insinfo/8SoundsUSB/SoundCard_REV2.jpg

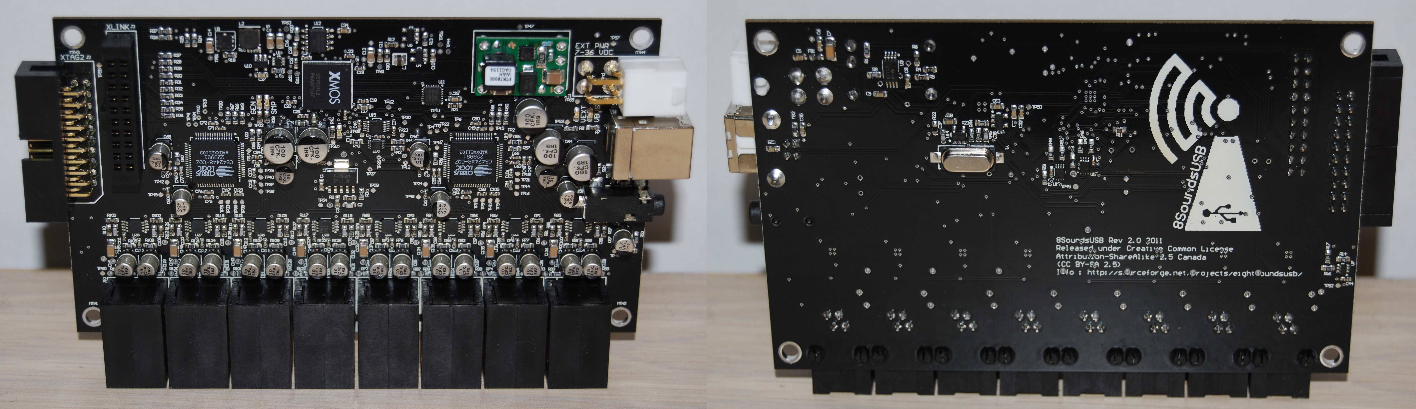
SoundCard_REV2.jpg
