insinfo/8SoundsUSB/8SoundsUSB.jpeg

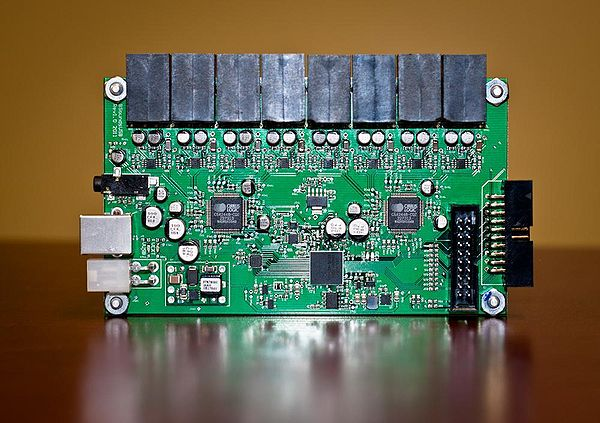
8SoundsUSB.jpeg
