insinfo/8SoundsUSB/README.md

# 8SoundsUSB
8 chanel USB SoundCard Hardware Design
