insinfo/8SoundsUSB/FabAssyPackages/8SoundsUSB-MIC_REV2.0.1_1/README.txt

Microphone PCB assembly procedure (8SoundsUSb-MIC)
This procedure occurs because of the configuration of the PCB. The electret microphone must assemble before the RJ-11 Connector 
1.	First mount the electret microphone and cut the lead flush with board, then solder it
2.	Second assemble the RJ-11 connector
