insinfo/8SoundsUSB/FabAssyPackages/8SoundsUSB_REV2.0.1_1/README.txt

Note that the board outline is in the Keepout layer .GKO.
