insinfo/8SoundsUSB/Hardware Design Files/8SoundsUSB-MIC_REV2.0.1/8SoundsUSB-MIC/Project Outputs for Microphone/Board Information - 8SoundsUSB-MIC.html

Altium customize

# Board Information Report

Date | : | 2011-12-08
Time | : | 20:31:57
Elapsed Time | : | 00:00:00
Filename | : | C:\SVN-S7\Altium\PCBs\8SoundsUSB-MIC\8SoundsUSB-MIC.PcbDoc
Units | : | mmmils

## Contents

Contents

Board Specification

General

Routing

Routing Information

Layer Information

Layer Information

Layer Pairs

Board Holes

Non-Plated Hole Size

Plated Hole Size

Board Slots

Non-Plated Slot Size

Plated Slot Size

Board Square Holes

Non-Plated Square Hole Size

Plated Square Hole Size

Other

Top Layer Annular Ring Size

Mid Layer Annular Ring Size

Bottom Layer Annular Ring Size

Pad Solder Mask

Pad Paste Mask

Pad Pwr/Gnd Expansion

Pad Relief Conductor Width

Pad Relief Air Gap

Pad Relief Entries

Via Solder Mask

Via Pwr/Gnd Expansion

Track Width

Arc Line Width

Arc Radius

Arc Degrees

Text Height

Text Width

Net Track Width

Net Via Size

## Board Specification

General
Board Size | 25.4mm x 23.4mm
Components on board | 22

Back to top

## Routing

Routing Information
Routing completion | 100,00%
Connections | 34
Connections routed | 34
Connections remaing | 0

Back to top

## Layer Information

Layer | Arcs | Pads | Vias | Tracks | Texts | Fills | Regions | ComponentBodies
Top Layer | 0 | 45 | 0 | 127 | 0 | 0 | 2 | 0
Bottom Layer | 0 | 12 | 0 | 71 | 0 | 0 | 2 | 0
Mechanical 1 | 0 | 0 | 0 | 0 | 0 | 0 | 0 | 23
Mechanical 13 | 0 | 0 | 0 | 8 | 0 | 0 | 0 | 0
Mechanical 15 | 0 | 0 | 0 | 4 | 0 | 0 | 0 | 0
Top Overlay | 2 | 0 | 0 | 1453 | 37 | 0 | 0 | 0
Bottom Overlay | 0 | 0 | 0 | 4 | 12 | 0 | 0 | 0
Top Paste | 0 | 0 | 0 | 0 | 0 | 0 | 0 | 0
Bottom Paste | 0 | 0 | 0 | 0 | 0 | 0 | 0 | 0
Top Solder | 0 | 0 | 0 | 0 | 0 | 0 | 0 | 0
Bottom Solder | 0 | 0 | 0 | 0 | 0 | 0 | 0 | 0
Drill Guide | 0 | 0 | 0 | 0 | 0 | 0 | 0 | 0
Keep-Out Layer | 0 | 0 | 0 | 5 | 0 | 0 | 0 | 0
Drill Drawing | 0 | 0 | 0 | 0 | 0 | 0 | 0 | 0
Multi-Layer | 0 | 11 | 18 | 0 | 0 | 0 | 0 | 0
Total | 2 | 68 | 18 | 1672 | 49 | 0 | 4 | 23

Back to top

Layer Pairs | Vias
Top Layer - Bottom Layer | 18
Total | 18

Back to top

## Board Holes

Non-Plated Hole Size | Pads | Vias
Total | 0 | 0

Back to top

Plated Hole Size | Pads | Vias
0mm | 57 | 0
0.3048mm | 0 | 18
0.7112mm | 3 | 0
1.15mm | 2 | 0
3.25mm | 2 | 0
3.5mm | 4 | 0
Total | 68 | 18

Back to top

## Board Slots

Non-Plated Slot Size / Length | Pads
Total | 0

Back to top

Plated Slot Size / Length | Pads
Total | 0

Back to top

## Board Square Holes

Non-Plated Square Hole Size | Pads
Total | 0

Back to top

Plated Square Hole Size | Pads
Total | 0

Back to top

## Other

Top Layer Annular Ring Size | Count
-3.25mm | 2
0.2888mm | 3
0.3048mm | 18
0.35mm | 2
1.5mm | 4
Total | 29

Back to top

Mid Layer Annular Ring Size | Count
-3.25mm | 2
0.2888mm | 3
0.3048mm | 18
0.35mm | 2
1.5mm | 4
Total | 29

Back to top

Bottom Layer Annular Ring Size | Count
-3.25mm | 2
0.2888mm | 3
0.3048mm | 18
0.35mm | 2
1.5mm | 4
Total | 29

Back to top

Pad Solder Mask | Count
0.1016mm | 68
Total | 68

Back to top

Pad Paste Mask | Count
0mm | 68
Total | 68

Back to top

Pad Pwr/Gnd Expansion | Count
0.508mm | 68
Total | 68

Back to top

Pad Relief Conductor Width | Count
0.254mm | 68
Total | 68

Back to top

Pad Relief Air Gap | Count
0.254mm | 68
Total | 68

Back to top

Pad Relief Entries | Count
4 | 68
Total | 68

Back to top

Via Solder Mask | Count
0.1016mm | 18
Total | 18

Back to top

Via Pwr/Gnd Expansion | Count
0.508mm | 18
Total | 18

Back to top

Track Width | Count
0.001mm | 1
0.0134mm | 1437
0.1mm | 16
0.254mm | 218
Total | 1672

Back to top

Arc Line Width | Count
0.25mm | 1
0.254mm | 1
Total | 2

Back to top

Arc Radius | Count
0.125mm | 1
4.85mm | 1
Total | 2

Back to top

Arc Degrees | Count
360 | 2
Total | 2

Back to top

Text Height | Count
0.3mm | 3
0.5mm | 22
1.524mm | 24
Total | 49

Back to top

Text Width | Count
0.05mm | 21
0.08mm | 4
0.1524mm | 2
0.254mm | 22
Total | 49

Back to top

Net Track Width | Count
1065.7302mm | 16
Total | 16

Back to top

Net Via Size | Count
0.6096mm | 16
Total | 16

Back to top
