insinfo/8SoundsUSB/Hardware Design Files/8SoundsUSB_REV2.0.1/8SoundsUSB/PCB/8SoundsUSB.PcbDoc.htm

Altium Reporting Options

# File in Previous Format

Date | : | 29/10/2012
Time | : | 23:22:21
Filename | : | C:\Users\Isaque\Desktop\Estudo Placa de som Hardware\Projeto 8 Sounds USB\Hardware Design Files\8SoundsUSB_REV2.0.1\8SoundsUSB\PCB\8SoundsUSB.PcbDoc

Version | Warning

This file was generated by an earlier version of the software
