insinfo/8SoundsUSB/Hardware Design Files/8SoundsUSB_REV2.0.1/8SoundsUSB/PCB/Project Outputs for 8SoundsUSB/Board Information - 8SoundsUSB.html

Altium customize

# Board Information Report

Date | : | 2011-12-07
Time | : | 19:11:10
Elapsed Time | : | 00:00:00
Filename | : | C:\SVN-S7\Altium\PCBs\8SoundsUSB\PCB\8SoundsUSB.PcbDoc
Units | : | mmmils

## Contents

Contents

Board Specification

General

Routing

Routing Information

Layer Information

Layer Information

Layer Pairs

Board Holes

Non-Plated Hole Size

Plated Hole Size

Board Slots

Non-Plated Slot Size

Plated Slot Size

Board Square Holes

Non-Plated Square Hole Size

Plated Square Hole Size

Other

Top Layer Annular Ring Size

Mid Layer Annular Ring Size

Bottom Layer Annular Ring Size

Pad Solder Mask

Pad Paste Mask

Pad Pwr/Gnd Expansion

Pad Relief Conductor Width

Pad Relief Air Gap

Pad Relief Entries

Via Solder Mask

Via Pwr/Gnd Expansion

Track Width

Arc Line Width

Arc Radius

Arc Degrees

Text Height

Text Width

Net Track Width

Net Via Size

## Board Specification

General
Board Size | 126.1mm x 74.1mm
Components on board | 415

Back to top

## Routing

Routing Information
Routing completion | 100,00%
Connections | 885
Connections routed | 885
Connections remaing | 0

Back to top

## Layer Information

Layer | Arcs | Pads | Vias | Tracks | Texts | Fills | Regions | ComponentBodies
Top Layer | 0 | 996 | 0 | 2706 | 0 | 0 | 20 | 0
GND PLANE | 0 | 0 | 0 | 4 | 0 | 0 | 1 | 0
POWER PLANE | 0 | 0 | 0 | 22 | 0 | 0 | 3 | 0
Bottom Layer | 0 | 119 | 0 | 977 | 0 | 0 | 15 | 0
Mechanical 1 | 0 | 0 | 0 | 32 | 0 | 0 | 0 | 22
Mechanical 13 | 6 | 0 | 0 | 56 | 0 | 0 | 0 | 14
Mechanical 15 | 0 | 0 | 0 | 80 | 0 | 0 | 0 | 0
Top Overlay | 30 | 0 | 0 | 467 | 742 | 0 | 0 | 0
Bottom Overlay | 7 | 0 | 0 | 30 | 100 | 0 | 3 | 0
Top Paste | 0 | 0 | 0 | 0 | 0 | 0 | 0 | 0
Bottom Paste | 0 | 0 | 0 | 0 | 0 | 0 | 0 | 0
Top Solder | 0 | 0 | 0 | 0 | 0 | 0 | 0 | 0
Bottom Solder | 0 | 0 | 0 | 0 | 0 | 0 | 0 | 0
Drill Guide | 0 | 0 | 0 | 0 | 0 | 0 | 0 | 0
Keep-Out Layer | 0 | 0 | 0 | 12 | 0 | 0 | 0 | 0
Drill Drawing | 0 | 0 | 0 | 0 | 0 | 0 | 0 | 0
Multi-Layer | 0 | 119 | 311 | 0 | 0 | 0 | 0 | 0
Total | 43 | 1234 | 311 | 4386 | 842 | 0 | 42 | 36

Back to top

Layer Pairs | Vias
Top Layer - Bottom Layer | 311
Total | 311

Back to top

## Board Holes

Non-Plated Hole Size | Pads | Vias
Total | 0 | 0

Back to top

Plated Hole Size | Pads | Vias
0mm | 951 | 0
0.3048mm | 9 | 260
0.33mm | 0 | 4
0.508mm | 0 | 20
0.7112mm | 0 | 27
0.89mm | 32 | 0
0.92mm | 4 | 0
0.9398mm | 40 | 0
1.4mm | 5 | 0
1.7mm | 2 | 0
1.8mm | 4 | 0
2.3mm | 2 | 0
3mm | 1 | 0
3.25mm | 16 | 0
3.5mm | 4 | 0
Total | 1070 | 311

Back to top

## Board Slots

Non-Plated Slot Size / Length | Pads
Total | 0

Back to top

Plated Slot Size / Length | Pads
Total | 0

Back to top

## Board Square Holes

Non-Plated Square Hole Size | Pads
Total | 0

Back to top

Plated Square Hole Size | Pads
Total | 0

Back to top

## Other

Top Layer Annular Ring Size | Count
-3.25mm | 16
-3mm | 1
-1.7mm | 2
0.1016mm | 32
0.2032mm | 9
0.3048mm | 228
0.33mm | 4
0.3302mm | 40
0.508mm | 20
0.5588mm | 27
0.68mm | 4
0.9mm | 32
1mm | 5
1.5mm | 6
1.5mm | 4
Total | 430

Back to top

Mid Layer Annular Ring Size | Count
-3.25mm | 16
-3mm | 1
-1.7mm | 2
0.0762mm | 40
0.1016mm | 32
0.2032mm | 9
0.3048mm | 228
0.33mm | 4
0.508mm | 20
0.5588mm | 27
0.68mm | 4
0.9mm | 32
1mm | 5
1.5mm | 6
1.5mm | 4
Total | 430

Back to top

Bottom Layer Annular Ring Size | Count
-3.25mm | 16
-3mm | 1
-1.7mm | 2
0.1016mm | 32
0.2032mm | 9
0.3048mm | 228
0.33mm | 4
0.3302mm | 40
0.508mm | 20
0.5588mm | 27
0.68mm | 4
0.9mm | 32
1mm | 5
1.5mm | 6
1.5mm | 4
Total | 430

Back to top

Pad Solder Mask | Count
0mm | 9
0.1016mm | 1225
Total | 1234

Back to top

Pad Paste Mask | Count
0mm | 1234
Total | 1234

Back to top

Pad Pwr/Gnd Expansion | Count
0.508mm | 1234
Total | 1234

Back to top

Pad Relief Conductor Width | Count
0.254mm | 1234
Total | 1234

Back to top

Pad Relief Air Gap | Count
0.254mm | 1234
Total | 1234

Back to top

Pad Relief Entries | Count
4 | 1234
Total | 1234

Back to top

Via Solder Mask | Count
0.1016mm | 311
Total | 311

Back to top

Via Pwr/Gnd Expansion | Count
0.508mm | 311
Total | 311

Back to top

Track Width | Count
0.05mm | 5
0.1mm | 388
0.1524mm | 1344
0.2mm | 102
0.2032mm | 565
0.254mm | 408
0.3048mm | 513
0.508mm | 804
0.635mm | 225
0.762mm | 1
0.889mm | 2
1.016mm | 8
1.27mm | 21
Total | 4386

Back to top

Arc Line Width | Count
0.1mm | 6
0.25mm | 24
0.254mm | 4
0.4mm | 8
0.6mm | 1
Total | 43

Back to top

Arc Radius | Count
0.0254mm | 1
0.05mm | 3
0.125mm | 24
0.2mm | 8
0.3mm | 1
0.5mm | 6
Total | 43

Back to top

Arc Degrees | Count
354 | 1
360 | 42
Total | 43

Back to top

Text Height | Count
0.5mm | 416
1mm | 16
1.524mm | 409
1.8mm | 1
Total | 842

Back to top

Text Width | Count
0.08mm | 416
0.15mm | 1
0.16mm | 15
0.254mm | 409
0.3mm | 1
Total | 842

Back to top

Net Track Width | Count
1423.4834mm | 227
Total | 227

Back to top

Net Via Size | Count
0.6096mm | 227
Total | 227

Back to top
