insinfo/8SoundsUSB/Hardware Design Files/README.txt

REVISIONS
Changes made from Rev2.0 to REV2.0.1 
•	Part number and mafucfacturer added in 8SounsdUSB.xls file. (all other files are still good at REV2.0)
