insinfo/8SoundsUSB/BlockDiagram.png

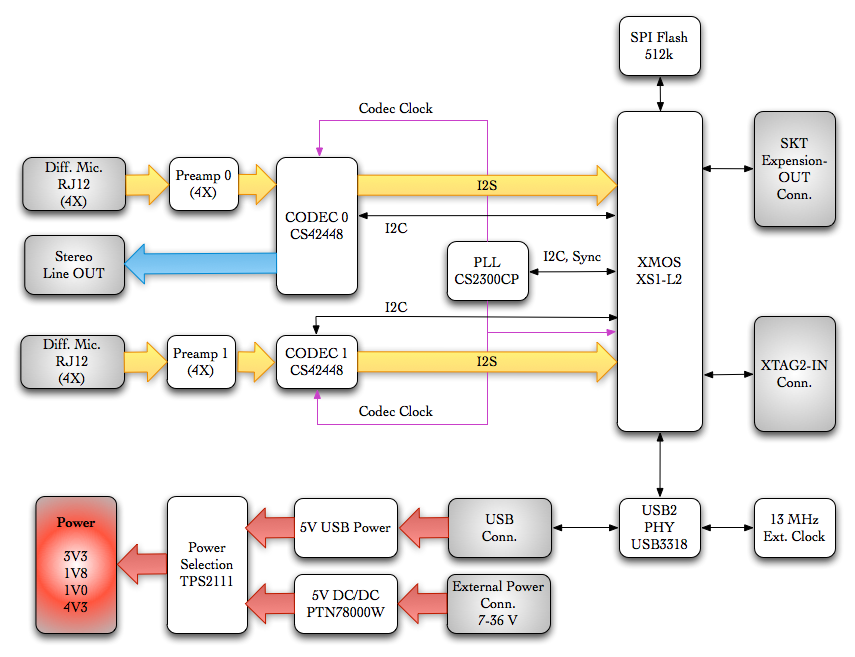
BlockDiagram.png
