insinfo/8SoundsUSB/FabAssyPackages/8SoundsUSB-Cable_BOM.xls

Designator | Manufacturer | Part Number | Quantity
RJ-11PCB | Stewart Connector | 940-SP-3046 | 1
RJ-11MIC | Stewart Connector | 940-SP-3046 | 1
Cable twisted pair, 4-conductors, 22, 24 ,26 AWG |  |  | 1m
