insinfo/8SoundsUSB/FabAssyPackages/8SoundsUSB_REV2.0.1_1/8SoundsUSB_BOM.xls

Designator | Description | Manufacturer | Part Number | Footprint | Quantity
C1, C3, C13 | MLCC 1uF 0603 X5R 10V | Murata | GRM188R61A105KA61 | 3-0603 | 3
C2 | MLCC 15pF 0603 C0G 50V | Murata | GRM1885C1H150JA01D | 3-0603 | 1
C4, C64, C65, C82, C83 | Al Elec 100uF CaseD 16V | Panasonic | EEEFK1C101P | AL_ELEC_SMD_D | 5
C5, C6 | MLCC 0.10uF 0603 X7R 50V | Murata | GRM188R71H104KA93D | 3-0603 | 2
C7, C133, C134, C135, C136, C141, C142, C143, C144 | MLCC 2.2uF 1206 X7R 50V | Murata | GRM31CR71H225KA88L | 8-1206 | 9
C8, C9, C28, C30, C32, C33, C34, C35, C39 | MLCC 100nF 0603 X7R 16V | Murata | GRM188R71C104KA01 | 3-0603 | 9
C10, C17, C26 | MLCC 4.7uF 0603 X5R 6.3V | Murata | GRM188R60J475KE19 | 3-0603 | 3
C11 | MLCC 330pF 0603 COG 50V | Murata | GRM1885C1H331JA01 | 3-0603 | 1
C12, C14, C15, C16 | MLCC 10uF 0805 X5R 10V | Murata | GRM21BR61A106KE19 | 6-0805 | 4
C18, C19, C20, C21, C22, C23, C24, C25, C36, C40, C41, C42, C43, C44, C47, C52, C53, C56, C62, C63, C66, C69, C71, C74, C75, C78, C80, C81, C84, C137, C138, C139, C140, C145, C146, C147, C148 | MLCC 100nF 0402 X7R 16V | Murata | GRM155R71C104KA88 | 2-0402 | 37
C27, C29 | MLCC 10nF 0603 X7R 50V | Murata | GRM188R71H103KA01 | 3-0603 | 2
C31 | MLCC 2.2uF 0603 X5R 10V | Murata | GRM188R61A225KE34 | 3-0603 | 1
C37, C38 | MLCC 33pF 0603 COG 50V | Murata | GRM1885C1H330JA01 | 3-0603 | 2
C45, C46, C67, C68, C89, C90, C95, C96, C101, C102, C107, C108, C113, C114, C119, C120, C125, C126, C131, C132 | Al Elec 10uF CaseB 16V | Panasonic | EEEFK1C100R | AL_ELEC_SMD_B | 20
C48, C49, C50, C51, C54, C55, C70, C72, C73, C76, C77, C91, C92, C103, C104, C115, C116, C127, C128 | MLCC 10000pF 0402 X7R 25V | Murata | GRM155R71E103KA01D | 2-0402 | 19
C57, C59, C61, C79 | Al Elec 4.7uF CaseB 35V | Panasonic | EEEFK1V4R7R | AL_ELEC_SMD_B | 4
C58, C60 | MLCC 2.2uF 0603 X5R 10V | Murata | GRM1885C1H222JA01 | 3-0603 | 2
C85, C86, C87, C88, C97, C98, C99, C100, C109, C110, C111, C112, C121, C122, C123, C124 | MLCC 470pF 0603 COG 50V | Murata | GRM1885C1H471JA01D | 3-0603 | 16
C93, C94, C105, C106, C117, C118, C129, C130 | Temperature Compensating 2700pF 0402 COG 10V | Murata | GRM1557U1A272JA01D | 2-0402 | 8
D1 | LED, GREEN, 0603 | Kingbright | APT1608CGCK | LED_0603 | 1
D2 | LED, GREEN, 0603 | Kingbright | APT1608CGCK | LED_0603 | 1
D3 | LED, GREEN, 0603 | Kingbright | APT1608CGCK | LED_0603 | 1
D4 | LED, GREEN, 0603 | Kingbright | APT1608CGCK | LED_0603 | 1
D5 | LED, GREEN, 0603 | Kingbright | APT1608CGCK | LED_0603 | 1
FB1, FB2 | Ferrite 300R -1200mA | Murata | BLM18SG331TN1D | 3-0603 | 2
J1 | Molex connector | Molex | 0026013115 | MOLEX-P4 | 1
J2 | IDC Boxed Header, Right Angle, PCB Mount, Polarised, 20 Way, 2x10, 0.1" Pitch | Sullins | SBH11-PBPC-D10-RA-BK | HEADER-2X10-100mil | 1
J3 | IDC Header Female, Straight, PCB Mount, Polarised, 20 Way, 2x10, 0.1" Pitch | Sullins | SFH11-PBPC-D10-ST-BK | HEADER-2X10-100mil_STRAIGHT | 1
J4 | USB 2.0 connectors Connecteurs USB 2.0 | Lumberg | 2411 02 | 787924 | 1
J5 | Stereo Jack 1/8 in, 3.5 mm | CUI Inc | SJ-3524-SMT | SJ-3524-SMT | 1
J6, J7, J8, J9, J10, J11, J12, J13 | CONN 6-4 MOD JACK | Stewart Connector | SS-6446-NF | RJ11 | 8
L1 | Power Inductor, 2.2uH, 0.7A, 260mR DCR | Taiyo Yuden | CBC2016T2R2M | Inductor | 1
L2 | Power Inductor, 3.3uH, 1.7A, 78mR DCR | Murata | LQH44PN3R3MP0 | INDUCTOR_1515 | 1
MTH1, MTH2, MTH3, MTH4 |  |  |  | Mounting Hole | 4
R1 | RES 21k 0603 1% | ROHM | MCR03EZPFX2102 | 3-0603 | 1
R2 | RES 24.9K 0603 1% | ROHM | MCR03EZPFX2493 | 3-0603 | 1
R3, R9, R13, R20, R23, R53, R55, R73, R75, R76, R77, R89, R91, R92, R93, R105, R107, R108, R109, R121, R123, R124, R125 | RES 10k 0603 1% | ROHM | MCR03EZPFX1002 | 3-0603 | 23
R4, R5, R21, R38, R39, R40 | RES 1k 0603 1% | ROHM | MCR03EZPFX1001 | 3-0603 | 6
R6 | RES 200R 0603 1% | ROHM | MCR03EZPFX2000 | 3-0603 | 1
R7, R68, R69, R70, R71, R84, R85, R86, R87, R100, R101, R102, R103, R116, R117, R118, R119 | RES 634R 0603 1% | ROHM | MCR03EZPFX6340 | 3-0603 | 17
R8, R15 | RES 1.8k 0603 1% | ROHM | MCR03EZPFX1801 | 3-0603 | 2
R10, R18 | RES 6.8k 0603 1% | ROHM | MCR03EZPFX6801 | 3-0603 | 2
R11 | RES 2.2R 0603 1% | ROHM | MCR03EZPJ2R2 | 3-0603 | 1
R12 | RES 1.5k 0603 1% | ROHM | MCR03EZPFX1501 | 3-0603 | 1
R14, R24, R25, R26, R27, R28, R29, R30, R31, R32, R33, R34, R35, R36, R37, R41, R42, R43, R46, R47, R48, R49, R50, R51 | RES 33R 0603 1% | ROHM | MCR03EZPFX33R0 | 3-0603 | 24
R16, R17, R19 | RES 47k 0603 1% | ROHM | MCR03EZPFX4702 | 3-0603 | 3
R22 | RES 8k06 0603 1% | ROHM | MCR03EZPFX8061 | 3-0603 | 1
R44 | RES 2.2M 0603 5% | ROHM | MCR03EZPJ225 | 3-0603 | 1
R45, R52, R54 | RES 470R 0603 1% | ROHM | MCR03EZPFX4700 | 3-0603 | 3
R56, R57, R58, R59, R60, R61, R62, R63, R64, R65, R66, R67 | RES 4.7k 0603 1% | ROHM | MCR03EZPFX4701 | 3-0603 | 12
R72, R74, R82, R83, R88, R90, R98, R99, R104, R106, R114, R115, R120, R122, R130, R131 | RES 100k 0603 1% | ROHM | MCR03EZPFX1003 | 3-0603 | 16
R78, R79, R80, R81, R94, R95, R96, R97, R110, R111, R112, R113, R126, R127, R128, R129 | RES 634R 0603 1% | ROHM | MCR03EZPFX91R0 | 3-0603 | 16
TP1, TP2, TP3, TP4, TP5, TP6, TP7, TP8, TP9, TP10, TP11, TP12, TP13, TP14, TP15, TP16, TP17, TP18, TP19, TP20, TP21, TP22, TP23, TP24, TP25, TP26, TP27, TP28, TP29, TP30, TP31, TP32, TP33, TP34, TP35, TP36, TP37, TP38, TP39, TP40, TP41, TP42, TP43, TP44, TP45, TP46, TP47, TP48, TP49, TP50, TP51, TP52, TP53, TP54, TP55, TP56, TP57, TP58, TP59, TP60, TP61, TP62, TP63, TP64, TP65, TP66, TP67, TP68, TP69, TP70, TP71, TP72, TP73, TP74, TP75, TP76, TP77, TP78, TP79, TP80, TP81 |  |  |  | TP | 81
U1 | ULTRALOW-NOISE, HIGH PSRR, FAST RF 500-mA LOW-DROPOUT LINEAR REGULATORS | Texas instruments | TPS79501DCQ | SOT223-6L | 1
U2 | 1.5-A, Wide-Input Adjustable Switching Regulator | Texas Instrument | PTN78000W | PTN78000W | 1
U3 | Dual In/Single Out Autoswitching Power MUX | Texas Instrument | TPS2111 | TSOP65P640-8AL | 1
U4 | 1.5 MHz, 600 mA Step-Down DC-DC Converter | ON Semiconductor | NCP1521B | SOT23-5AL_MOD(1-07) | 1
U5 | Event-driven dual-core processor XS1-L2 124QFN | XMOS | XS1-L02A-QF124-C4 | QFN-124 | 1
U6 | Voltage Detector Series with Programmable Delay | ON Semiconductor | NCP303LSN30T1G | SOT23-5AL_MOD(1-07) | 1
U7 | TinyLogic UHS 2 Input Non-Inverting Multiplexer | Fairchild | NC7SZ157P6X | SOT363-6L | 1
U8 | 1.5A Low Voltage Current Mode Synchronous PWM Buck Regulator | Fairchild | FAN2012 | MLP-6-LEAD-3X3mm | 1
U9 | TinyLogic UHS Dual Buffer | Fairchild | NC7WZ07P6X | SOT363-6L | 1
U10 | Voltage Detector Serieswith Programmable Delay | ON Semiconductor | NCP303LSN09T1G | SOT23-5AL_MOD(1-07) | 1
U11 | USB-IF 'High-Speed' compliant to USB 2.0 | SMSC | USB3318 | QFN50P400X400-24V9L | 1
U12 | 4-megabit 2.3-volt or 2.7-volt Minimum SPI Serial Flash Memory | ATMEL | AT25DF041A-SSH | 8S1_L | 1
U13 | 150 mA CMOS Low Iq LDO | ON Semiconductor | NCP699SN18 | SOT23-5AL_MOD(1-07) | 1
U14 | TinyLogic UHS Unbuffered Inverter | Fairchild | NC7SZU04M5X | SOT23-5AL_MOD(1-07-26) | 1
U15 | Fractional-N Clock Multiplier with Internal LCO | Cirrus Logic | CS2300-CP | TSSOP50P490-10AL | 1
U16, U17, U18 | TinyLogic UHS Triple Buffer | Fairchild | NC7NZ34K8X | NC7NZ34 | 3
U19, U20 | 108 dB, 192 kHz 6-in, 8-out Multi-Channel Codec | Cirrus Logic | CS42448 | QFN50P1200X1200-64V1L-MOD | 2
U21, U22, U23, U24, U25, U26, U27, U28 | High Current, Low Distortion Rail-to-Rail Output Audio Operational Amplifier | National Semiconductor | LME49726MY | LME49726 | 8
Y1 | Crystal, 13MHz, HC49/US SMD, Fundamental, 18pF, Tol. ±30ppm, Stab. ±30ppm | Abracon | ABLS2-13.000MHz-D4Y | X_TAL | 1
