insinfo/8SoundsUSB/Hardware Design Files/8SoundsUSB_REV2.0.1/8SoundsUSB/PCB/Project Outputs for 8SoundsUSB/8SoundsUSB_bot.xls

Sheet: BOM Report
Bill of Materials |  |  | Bill of Materials For PCB Document [8SoundsUSB.PcbDoc]
Source Data From: |  | 8SoundsUSB.PcbDoc
Project: |  | 8SoundsUSB.PrjPCB
Variant: |  | None
Creation Date: | 2011-10-03 | 19:47:46
Print Date: | 40819 | 40819.82503
Footprint | Comment | #Column Name Error:LibRef | Designator | Description | Quantity
3-0603 |  |  | C5 | MLCC 0.10uF 0603 X7R 50V | 1
3-0603 |  |  | C6 | MLCC 0.10uF 0603 X7R 50V | 1
8-1206 |  |  | C7 | MLCC 2.2uF 1206 X7R 50V | 1
3-0603 |  |  | C8 | MLCC 100nF 0603 X7R 16V | 1
3-0603 |  |  | C9 | MLCC 100nF 0603 X7R 16V | 1
3-0603 |  |  | C29 | MLCC 10nF 0603 X7R 50V | 1
3-0603 |  |  | C30 | MLCC 100nF 0603 X7R 16V | 1
3-0603 |  |  | C31 | MLCC 2.2uF 0603 X5R 10V | 1
3-0603 |  |  | C32 | MLCC 100nF 0603 X7R 16V | 1
3-0603 |  |  | C35 | MLCC 100nF 0603 X7R 16V | 1
3-0603 |  |  | C37 | MLCC 33pF 0603 COG 50V | 1
3-0603 |  |  | C38 | MLCC 33pF 0603 COG 50V | 1
3-0603 |  |  | C39 | MLCC 100nF 0603 X7R 16V | 1
2-0402 |  |  | C42 | MLCC 100nF 0402 X7R 16V | 1
2-0402 |  |  | C43 | MLCC 100nF 0402 X7R 16V | 1
2-0402 |  |  | C44 | MLCC 100nF 0402 X7R 16V | 1
3-0603 | 300R-1200mA |  | FB1 |  | 1
3-0603 | 300R-1200mA |  | FB2 |  | 1
3-0603 |  |  | R1 | RES 21k 0603 1% | 1
3-0603 |  |  | R4 | RES 1k 0603 1% | 1
3-0603 |  |  | R5 | RES 1k 0603 1% | 1
3-0603 |  |  | R6 | RES 200R 0603 1% | 1
3-0603 |  |  | R9 | RES 10k 0603 1% | 1
3-0603 |  |  | R11 | RES 2.2R 0603 1% | 1
3-0603 |  |  | R14 | RES 33R 0603 1% | 1
3-0603 |  |  | R16 | RES 47k 0603 1% | 1
3-0603 |  |  | R17 | RES 47k 0603 1% | 1
3-0603 |  |  | R22 | RES 8k06 0603 1% | 1
3-0603 |  |  | R23 | RES 10k 0603 1% | 1
3-0603 |  |  | R44 | RES 2.2M 0603 5% | 1
3-0603 |  |  | R45 | RES 470R 0603 1% | 1
3-0603 |  |  | R46 | RES 33R 0603 1% | 1
3-0603 |  |  | R47 | RES 33R 0603 1% | 1
3-0603 |  |  | R48 | RES 33R 0603 1% | 1
3-0603 |  |  | R49 | RES 33R 0603 1% | 1
3-0603 |  |  | R50 | RES 33R 0603 1% | 1
3-0603 |  |  | R51 | RES 33R 0603 1% | 1
TP | TP |  | TP45 |  | 1
TP | TP |  | TP50 |  | 1
TP | TP |  | TP52 |  | 1
TSOP65P640-8AL | TPS2111 |  | U3 | Dual In/Single Out Autoswitching Power MUX | 1
SOT363-6L | NC7SZ157P6X |  | U7 | TinyLogic UHS 2 Input Non-Inverting Multiplexer | 1
SOT23-5AL_MOD(1-07) | NCP699SN18 |  | U13 |  | 1
SOT23-5AL_MOD(1-07-26) | NC7SZU04 |  | U14 | TinyLogic UHS Unbuffered Inverter | 1
NC7NZ34 | NC7NZ34 |  | U17 | TinyLogic UHS Triple Buffer | 1
NC7NZ34 | NC7NZ34 |  | U18 | TinyLogic UHS Triple Buffer | 1
X_TAL | 13MHz |  | Y1 | Crystal, 13MHz, HC49/US SMD, Fundamental, 18pF, Tol. ±30ppm, Stab. ±30ppm | 1
 |  |  |  |  | 47
Approved |  | Notes

Sheet: Project Information
Project Full Path | C:\SVN-S7\Altium\PCBs\8SoundsUSB\PCB\8SoundsUSB.PrjPCB
Project Filename | 8SoundsUSB.PrjPCB
Variant Name | None
Data-Source Filename | 8SoundsUSB.PcbDoc
Data-Source Full Path | C:\SVN-S7\Altium\PCBs\8SoundsUSB\PCB\8SoundsUSB.PcbDoc
Title | Bill of Materials For PCB Document [8SoundsUSB.PcbDoc]
Total Quantity | 415
Report Time | 19:47:46
Report Date | 2011-10-03
Report Date & Tine | 2011-10-03 19:47:46
Output Name | Bill of Materials
Output Type | BOM_PartType
Output Generator Name | BOM
Output Generator Description | Bill of Materials
