insinfo/8SoundsUSB/FabAssyPackages/8SoundsUSB-MIC_REV2.0.1_1/8SoundsUSB-MIC_BOM.xls

Designator | Manufacturer | Part Number | Quantity
C1, C2, C9 | Murata Electronics North America | GRM188R61A105KA61D | 3
C3, C4 | AVX Corporation | 0603YC101KAT2A | 2
C5, C6, C7, C8 | Kemet | C0603C104K8RACTU | 4
J1 | STMicroelectronics | TS472 | 1
J2 | Molex Connector Corporation | 95503-6651 | 1
MK1 | CUI Inc | CMA-4544PF-W | 1
pot | Copal Electronics Inc | CT94EW502 | 1
R1, R5 | Yageo | RC0603JR-072K2L | 2
R2 | Yageo | RC0603JR-0768RL | 1
R3, R4 | Yageo | RC0603JR-07100KL | 2
