insinfo/8SoundsUSB/Hardware Design Files/8SoundsUSB-MIC_REV2.0.1/8SoundsUSB-MIC/PCB-3D/SW3dPS-LFCSP-24.STEP

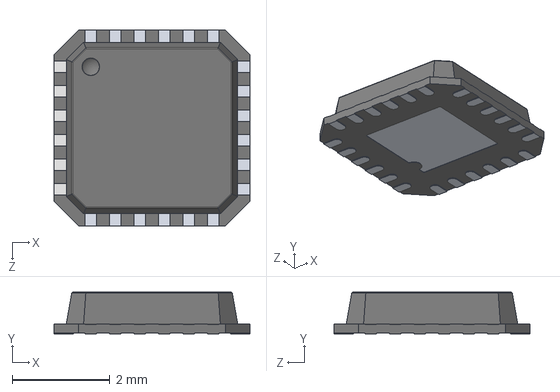
[picture p8: CAD file, 2021-08-12]
Hardware Design Files/8SoundsUSB-MIC_REV2.0.1/8SoundsUSB-MIC/PCB-3D/SW3dPS-LFCSP-24.STEP
4.00 x 0.85 x 4.00 mm
