insinfo/8SoundsUSB/Hardware Design Files/8SoundsUSB-MIC_REV2.0.1/8SoundsUSB-MIC/PCB-3D/SW3dPS-RJ11f.STEP

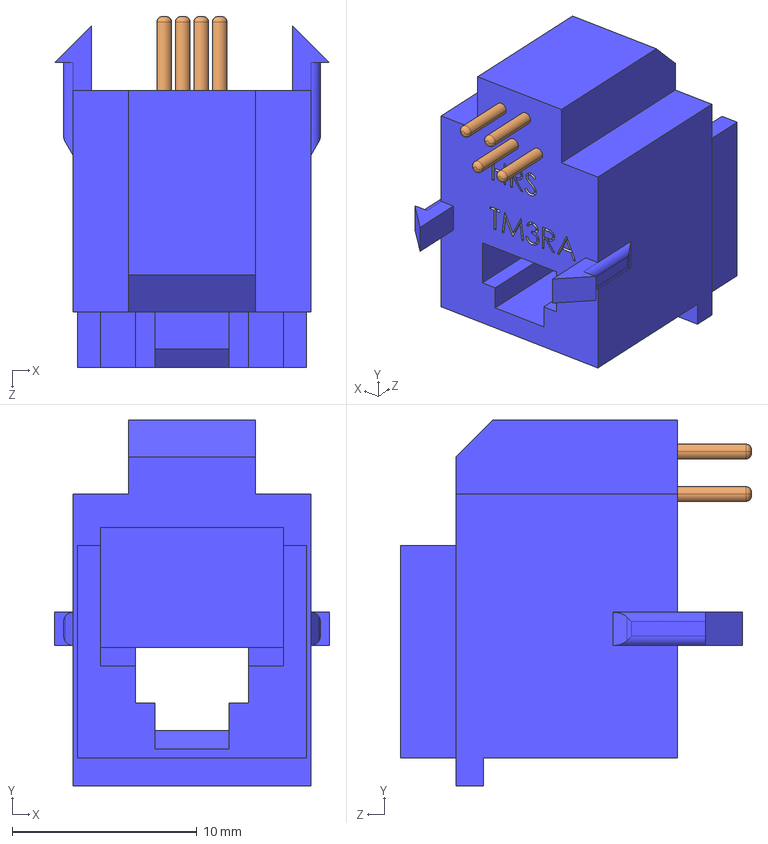
[picture p9: CAD file, 2021-08-12]
Hardware Design Files/8SoundsUSB-MIC_REV2.0.1/8SoundsUSB-MIC/PCB-3D/SW3dPS-RJ11f.STEP
14.9 x 19.8 x 19.0 mm
