insinfo/8SoundsUSB/Hardware Design Files/8SoundsUSB-MIC_REV2.0.1/8SoundsUSB-MIC/PCB-3D/User Library-POT-3262W-1.STEP

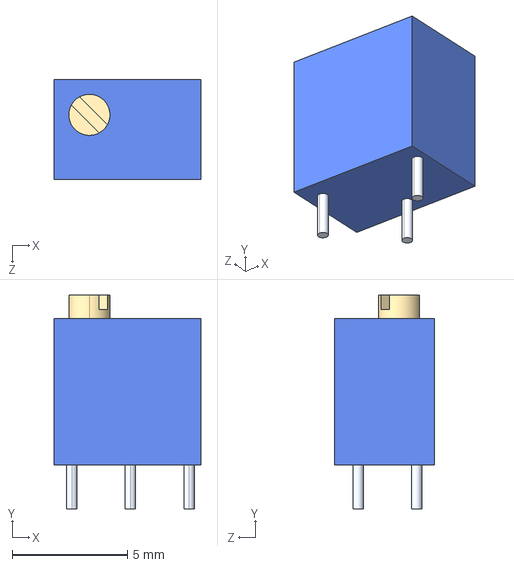
[picture p10: CAD file, 2021-08-12]
Hardware Design Files/8SoundsUSB-MIC_REV2.0.1/8SoundsUSB-MIC/PCB-3D/User Library-POT-3262W-1.STEP
6.35 x 9.27 x 4.32 mm
