insinfo/8SoundsUSB/Hardware Design Files/8SoundsUSB-MIC_REV2.0.1/8SoundsUSB-MIC/PCB-3D/SW3dPS-Panasonic_WM55A103.STEP

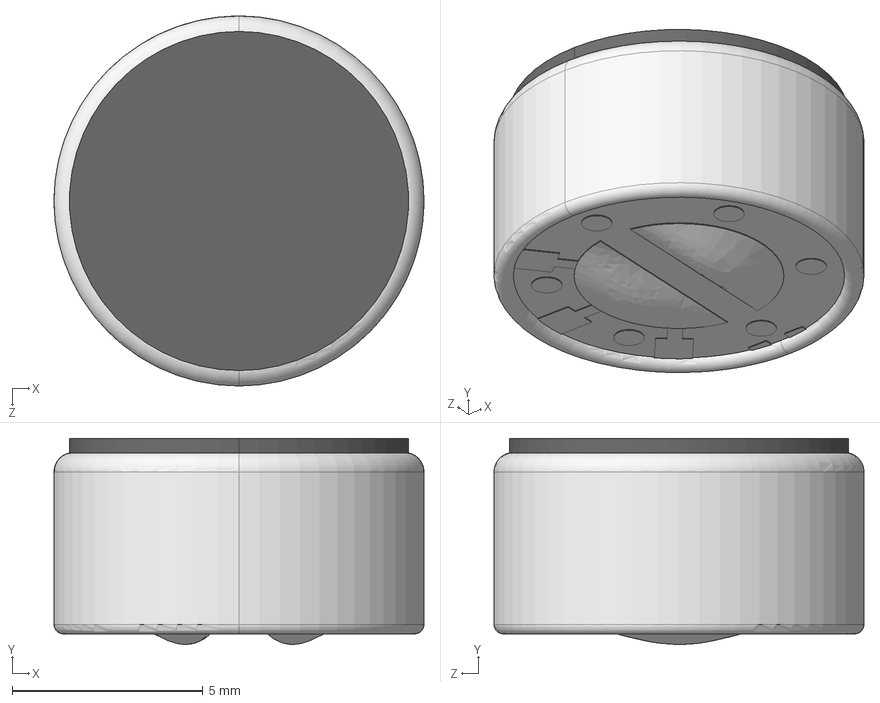
[picture p11: CAD file, 2021-08-12]
Hardware Design Files/8SoundsUSB-MIC_REV2.0.1/8SoundsUSB-MIC/PCB-3D/SW3dPS-Panasonic_WM55A103.STEP
9.70 x 5.41 x 9.70 mm
