insinfo/8SoundsUSB/Hardware Design Files/8SoundsUSB-MIC_REV2.0.1/8SoundsUSB-MIC/PCB-3D/SW3dPS-rj connector.STEP

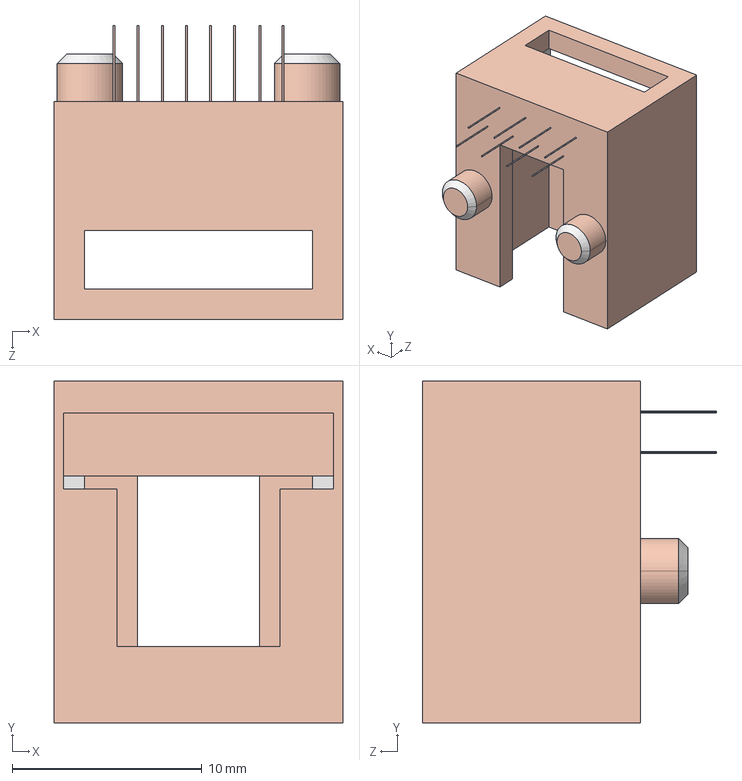
[picture p12: CAD file, 2021-08-12]
Hardware Design Files/8SoundsUSB-MIC_REV2.0.1/8SoundsUSB-MIC/PCB-3D/SW3dPS-rj connector.STEP
15.2 x 18.0 x 15.5 mm
