insinfo/8SoundsUSB/Hardware Design Files/8SoundsUSB-MIC_REV2.0.1/8SoundsUSB-MIC/PCB-3D/User Library-res0603.STEP

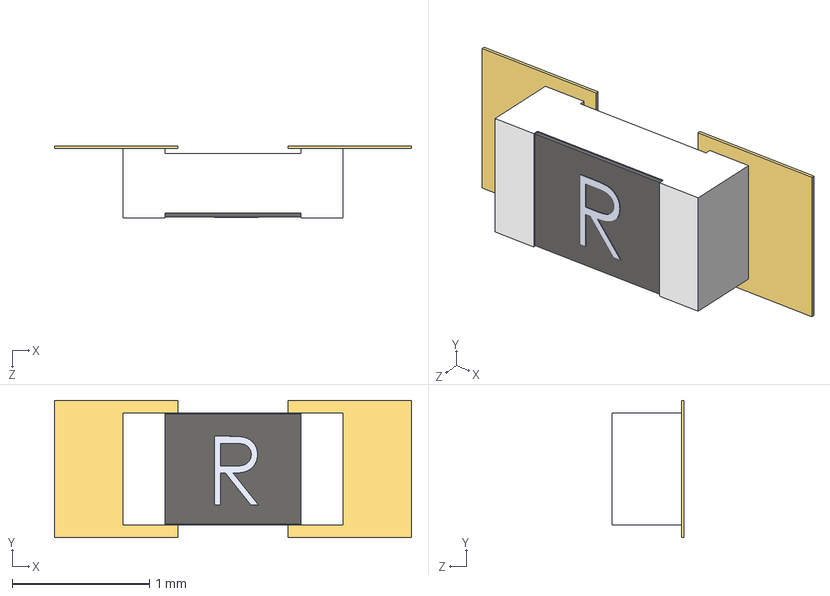
[picture p13: CAD file, 2021-08-12]
Hardware Design Files/8SoundsUSB-MIC_REV2.0.1/8SoundsUSB-MIC/PCB-3D/User Library-res0603.STEP
2.60 x 1.00 x 0.528 mm
User Library-res0603_res0603_body_??
User Library-res0603_pad_0603_??
