insinfo/8SoundsUSB/Hardware Design Files/8SoundsUSB-MIC_REV2.0.1/8SoundsUSB-MIC/PCB-3D/CUI-CMI-4537-SN69.STEP

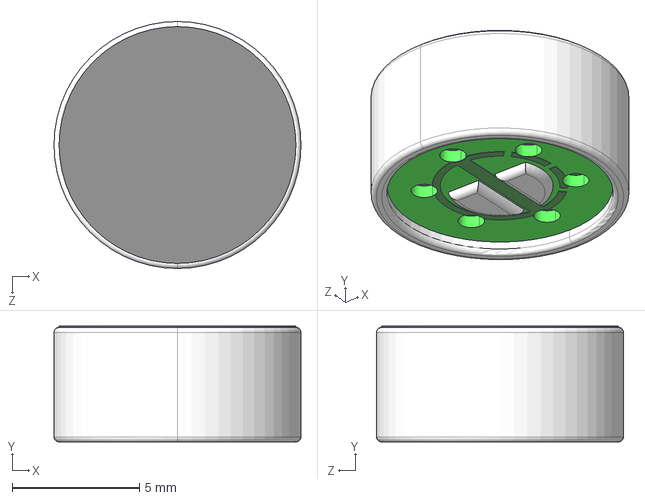
[picture p14: CAD file, 2021-08-12]
Hardware Design Files/8SoundsUSB-MIC_REV2.0.1/8SoundsUSB-MIC/PCB-3D/CUI-CMI-4537-SN69.STEP
9.70 x 4.55 x 9.70 mm
