insinfo/8SoundsUSB/Hardware Design Files/8SoundsUSB-MIC_REV2.0.1/8SoundsUSB-MIC/PCB-3D/SW3dPS-Bourns 3314J potentiometer x1.STEP

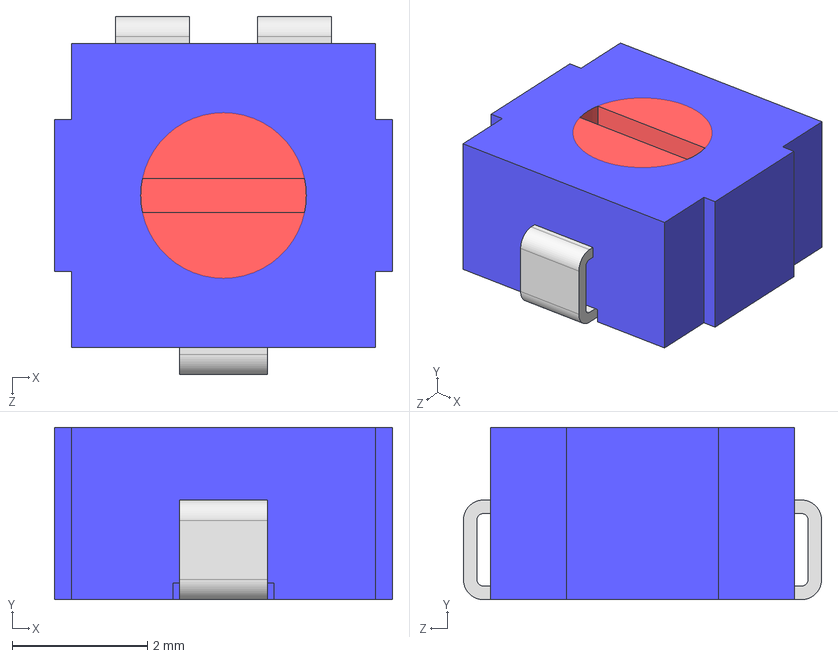
[picture p18: CAD file, 2021-08-12]
Hardware Design Files/8SoundsUSB-MIC_REV2.0.1/8SoundsUSB-MIC/PCB-3D/SW3dPS-Bourns 3314J potentiometer x1.STEP
5.00 x 2.55 x 5.30 mm
