insinfo/8SoundsUSB/Hardware Design Files/8SoundsUSB-MIC_REV2.0.1/8SoundsUSB-MIC/PCB-3D/SW3DPS-RJ-45 - VERTICAL-DEFAULT.STEP

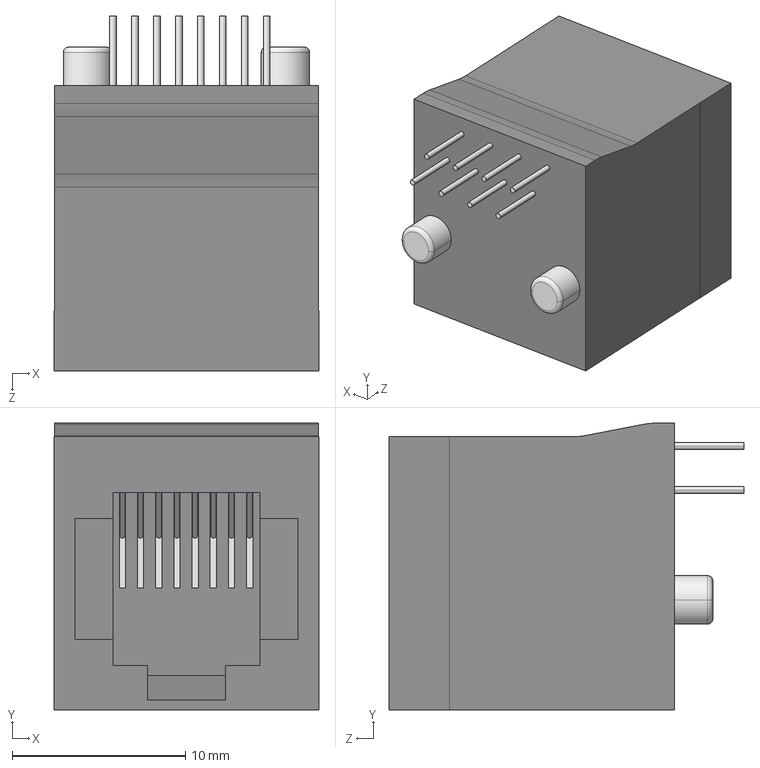
[picture p20: CAD file, 2021-08-12]
Hardware Design Files/8SoundsUSB-MIC_REV2.0.1/8SoundsUSB-MIC/PCB-3D/SW3DPS-RJ-45 - VERTICAL-DEFAULT.STEP
15.3 x 16.6 x 20.5 mm
