insinfo/8SoundsUSB/Hardware Design Files/8SoundsUSB-MIC_REV2.0.1/8SoundsUSB-MIC/PCB-3D/User Library-cap0603.STEP

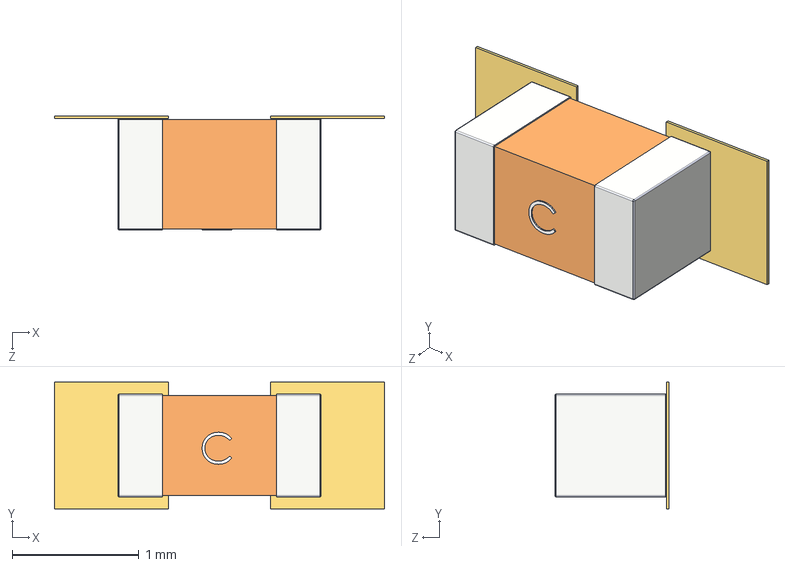
[picture p21: CAD file, 2021-08-12]
Hardware Design Files/8SoundsUSB-MIC_REV2.0.1/8SoundsUSB-MIC/PCB-3D/User Library-cap0603.STEP
2.60 x 1.00 x 0.9 mm
User Library-cap0603_cap0603_body_??
User Library-cap0603_pad_0603_??
