insinfo/8SoundsUSB/Schematics/8SoundsUSB-Cable_REV2.0.pdf

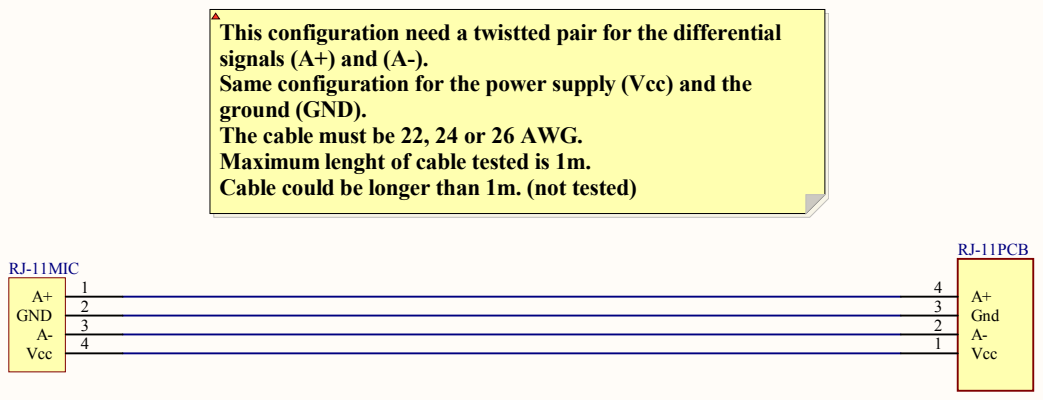
[picture p52: page 1]

ration need a twistted pair for the differential
ration for the power su
le cou

d be longer than 1m. (not tested

Rev.: Title: Date: Sheet: of 2011-12-08 1 1 | | Tea m mem bers : M.Ban dou , A.Bélan d, G.Cayer, S.C hoq uette, F.Gos seli n , F.Rob itai llle, D.Tel ly.Ki z ito

8Sou n d sUSB- Cable | A uthor: M.Ban dou

ke 2.5 Canada (CC BY-SA 2.5)
