insinfo/8SoundsUSB/Schematics/8SoundsUSB-MIC_REV2.0.pdf

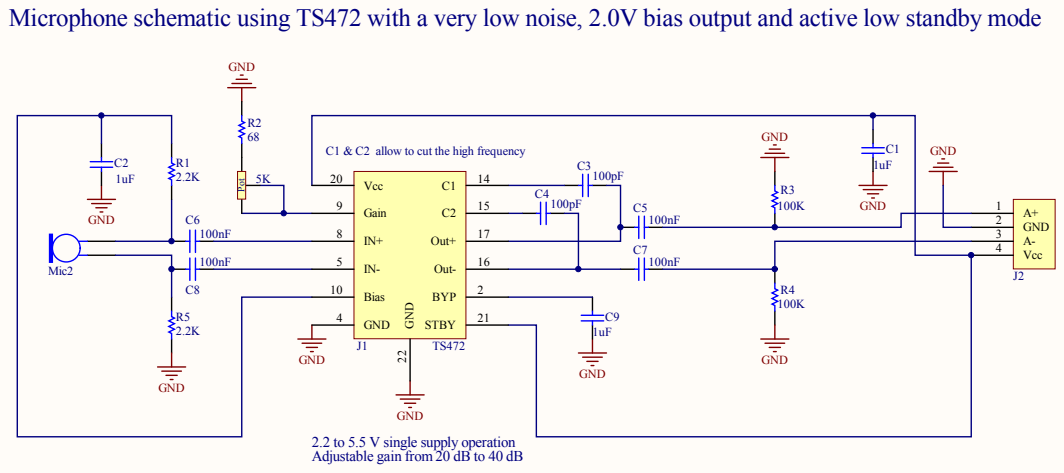
[picture p63: page 1]

Rev.: Title: Date: Sheet: of 2011-12-05 1 1 | | Tea m mem bers : M.Ban dou , A.Bélan d, G.Cayer, S.C hoq uette, F.Gos seli n , F.Rob itai llle, D.Tel ly.Ki z ito

8Sou n d sUSB-M I C | A uthor: M.Ban dou

ke 2.5 Canada (CC BY-SA 2.5)

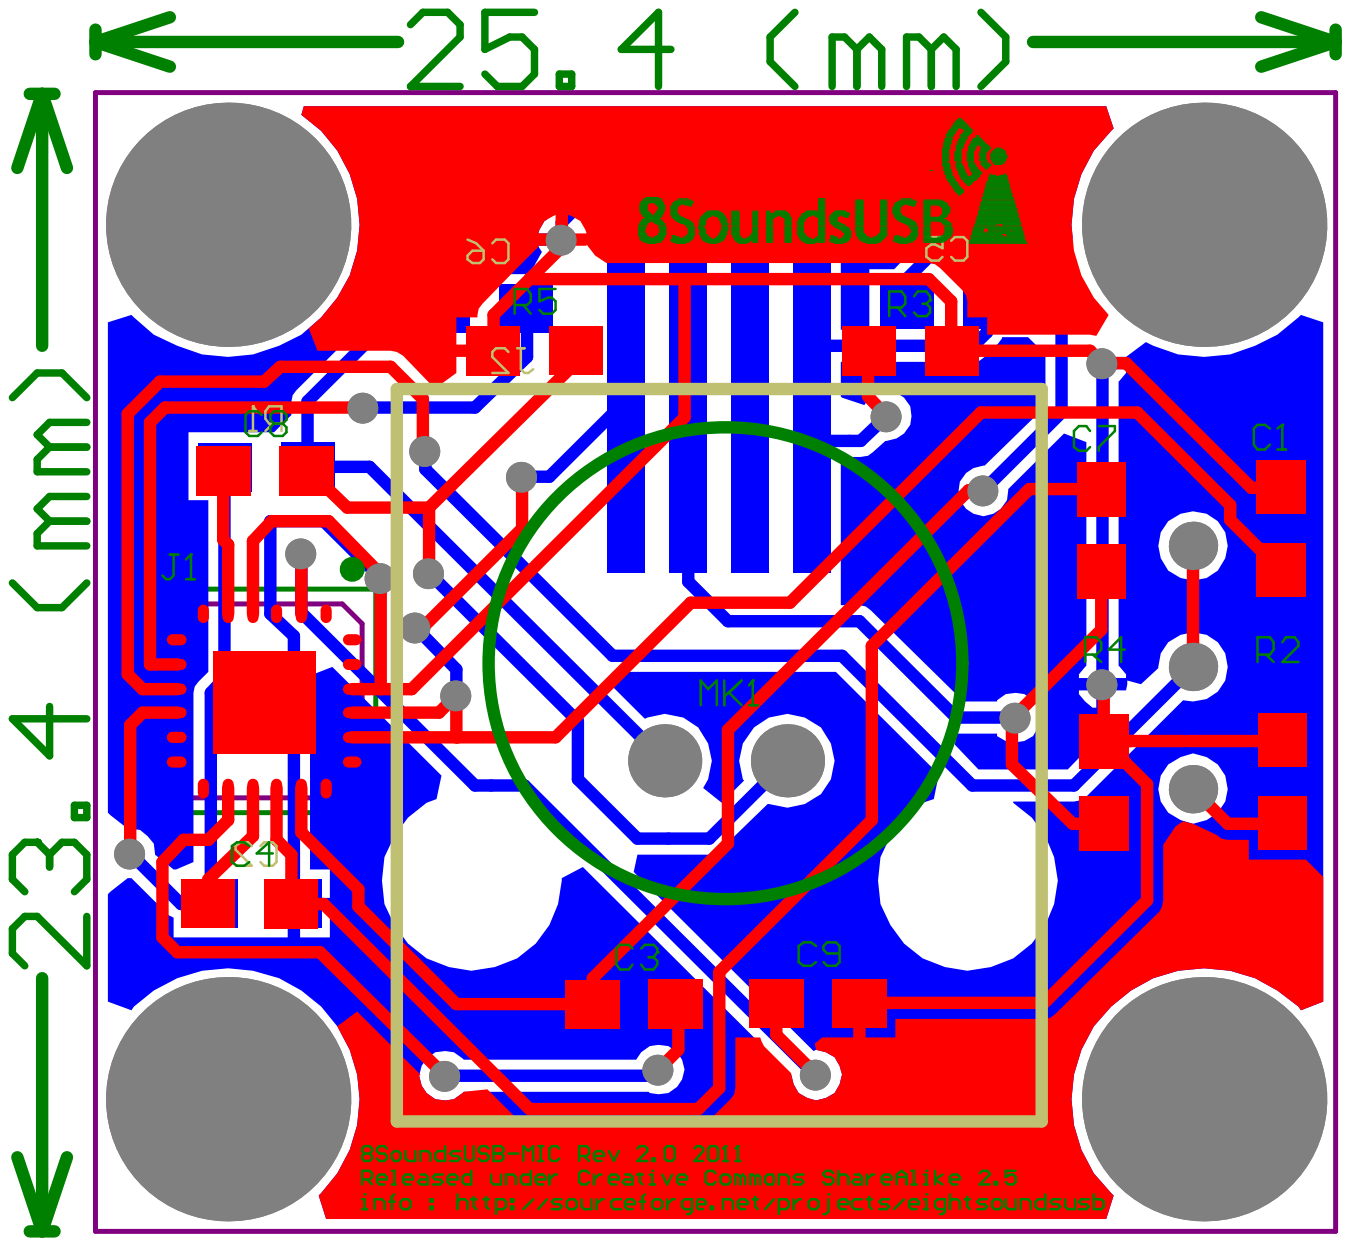
[picture p64: page 2]

Bill of Materials | 8SoundsUSB-MIC
Source Data From: | 8SoundsUSB-MIC.PrjPcb
Project: | | 8SoundsUSB-MIC.PrjPcb
Variant: | | None
Creation Date: 2011-12-08 | 20:34:44
Print Date: | 40885 | 40885,8575
#Column Name#ColumnName ErLibRef | | Designator | #Column Name Error:Description | Quantity

| Cap Cap Cap TS472 RJ-11-MIC Mic2 CT-94 Res1 Res1 Res1 | C1, C2, C9 | | 3
| | C3, C4 | | 2
| | C5, C6, C7, C8 | | 4
| | J1 | | 1
| | J2 | | 1
| | MK1 | | 1
| | pot | | 1
| | R1, R5 | | 2
| | R2 | | 1
| | R3, R4 | | 2
Approved Notes | | | | 18
