insinfo/8SoundsUSB/Hardware Design Files/8SoundsUSB-MIC_REV2.0.1/8SoundsUSB-MIC/Documentation/RJ-11 SMT.pdf

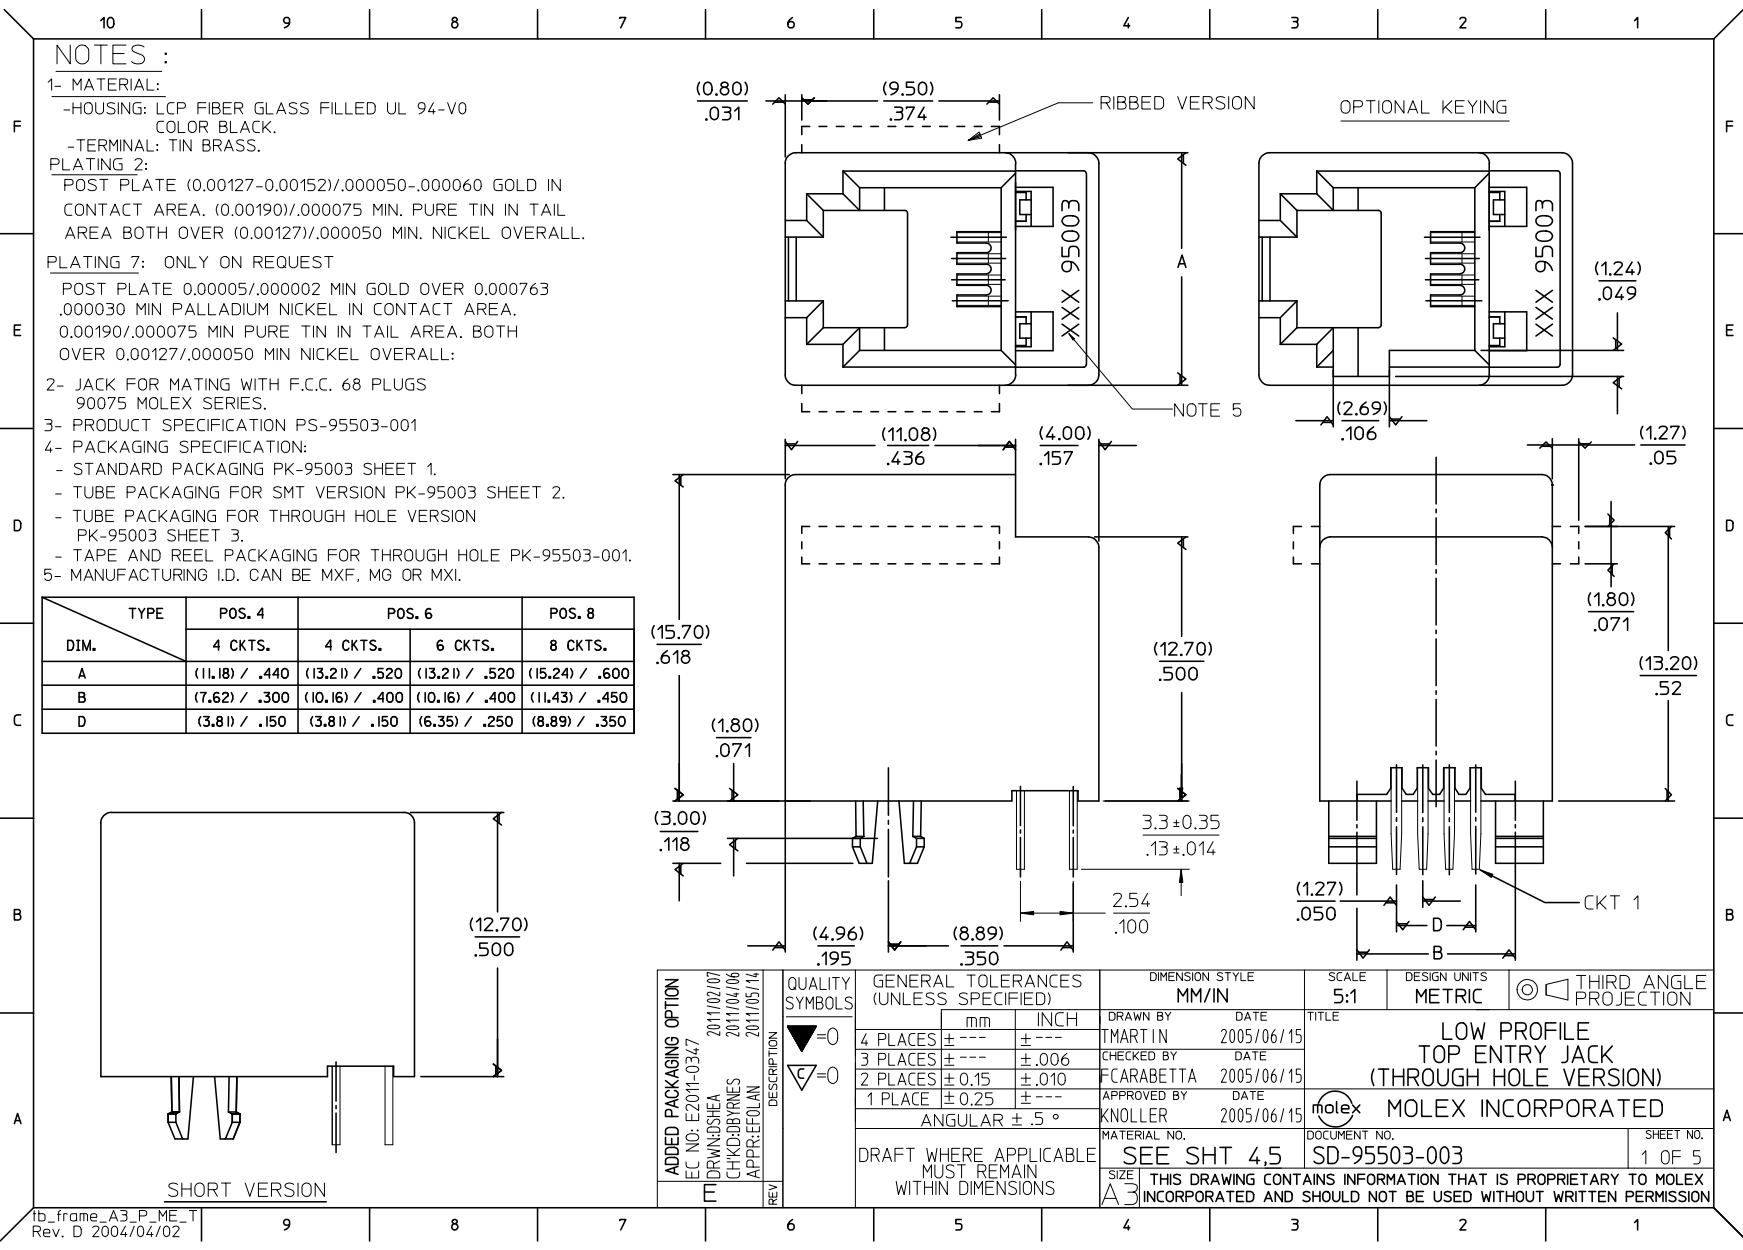
[picture p65: page 1]

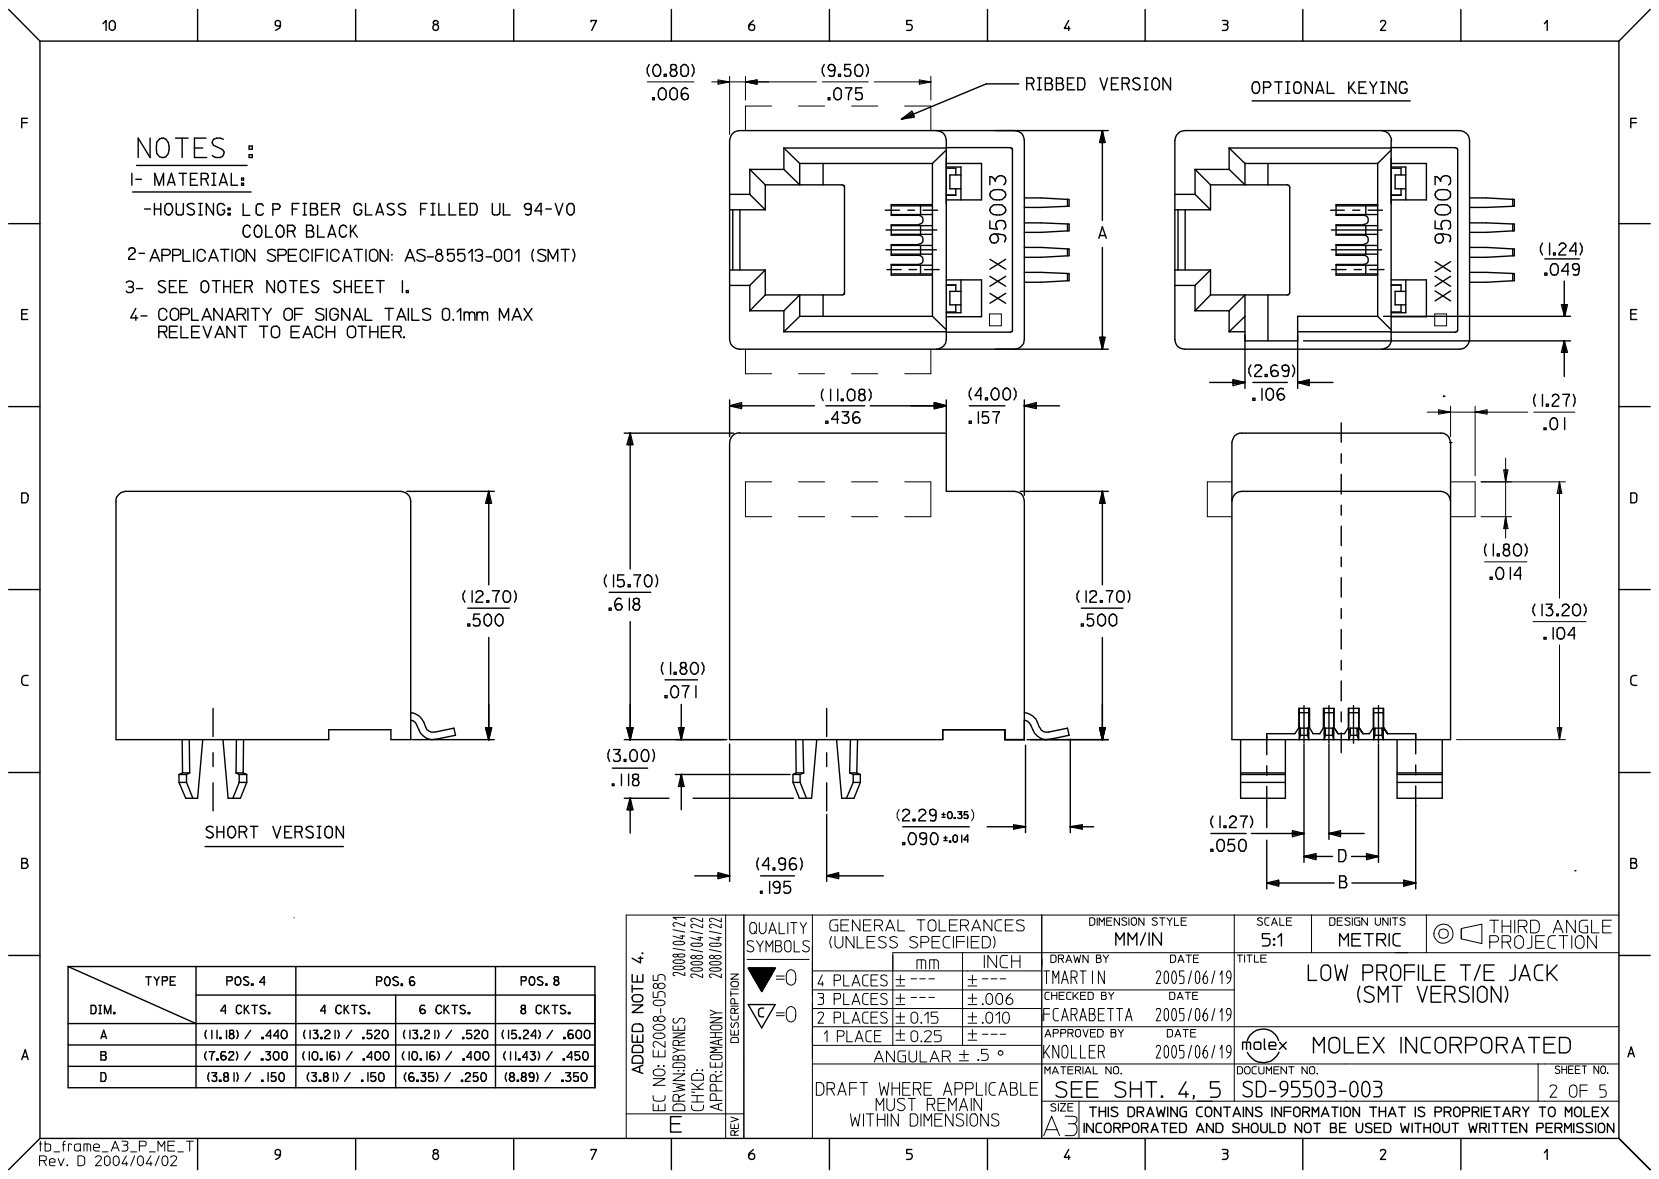
[picture p66: page 2]

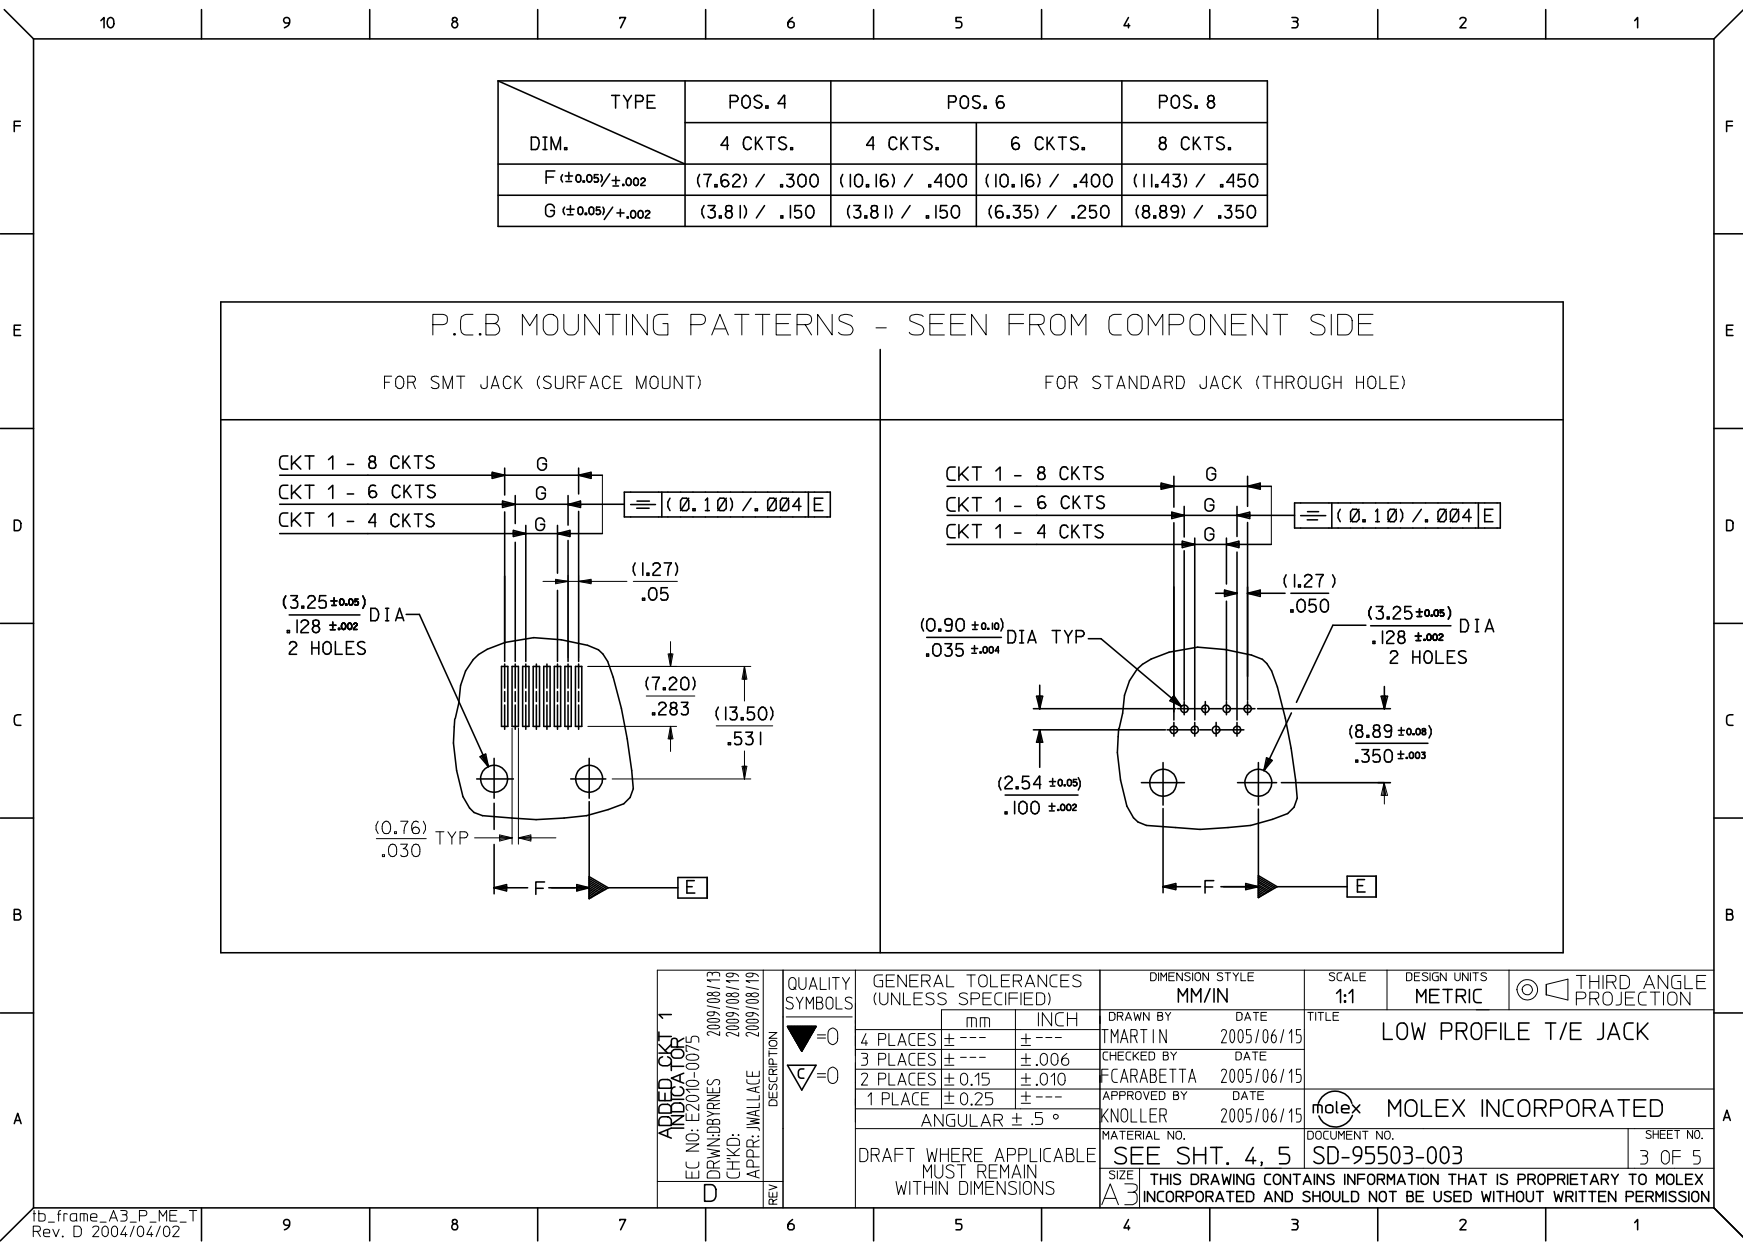
[picture p67: page 3]

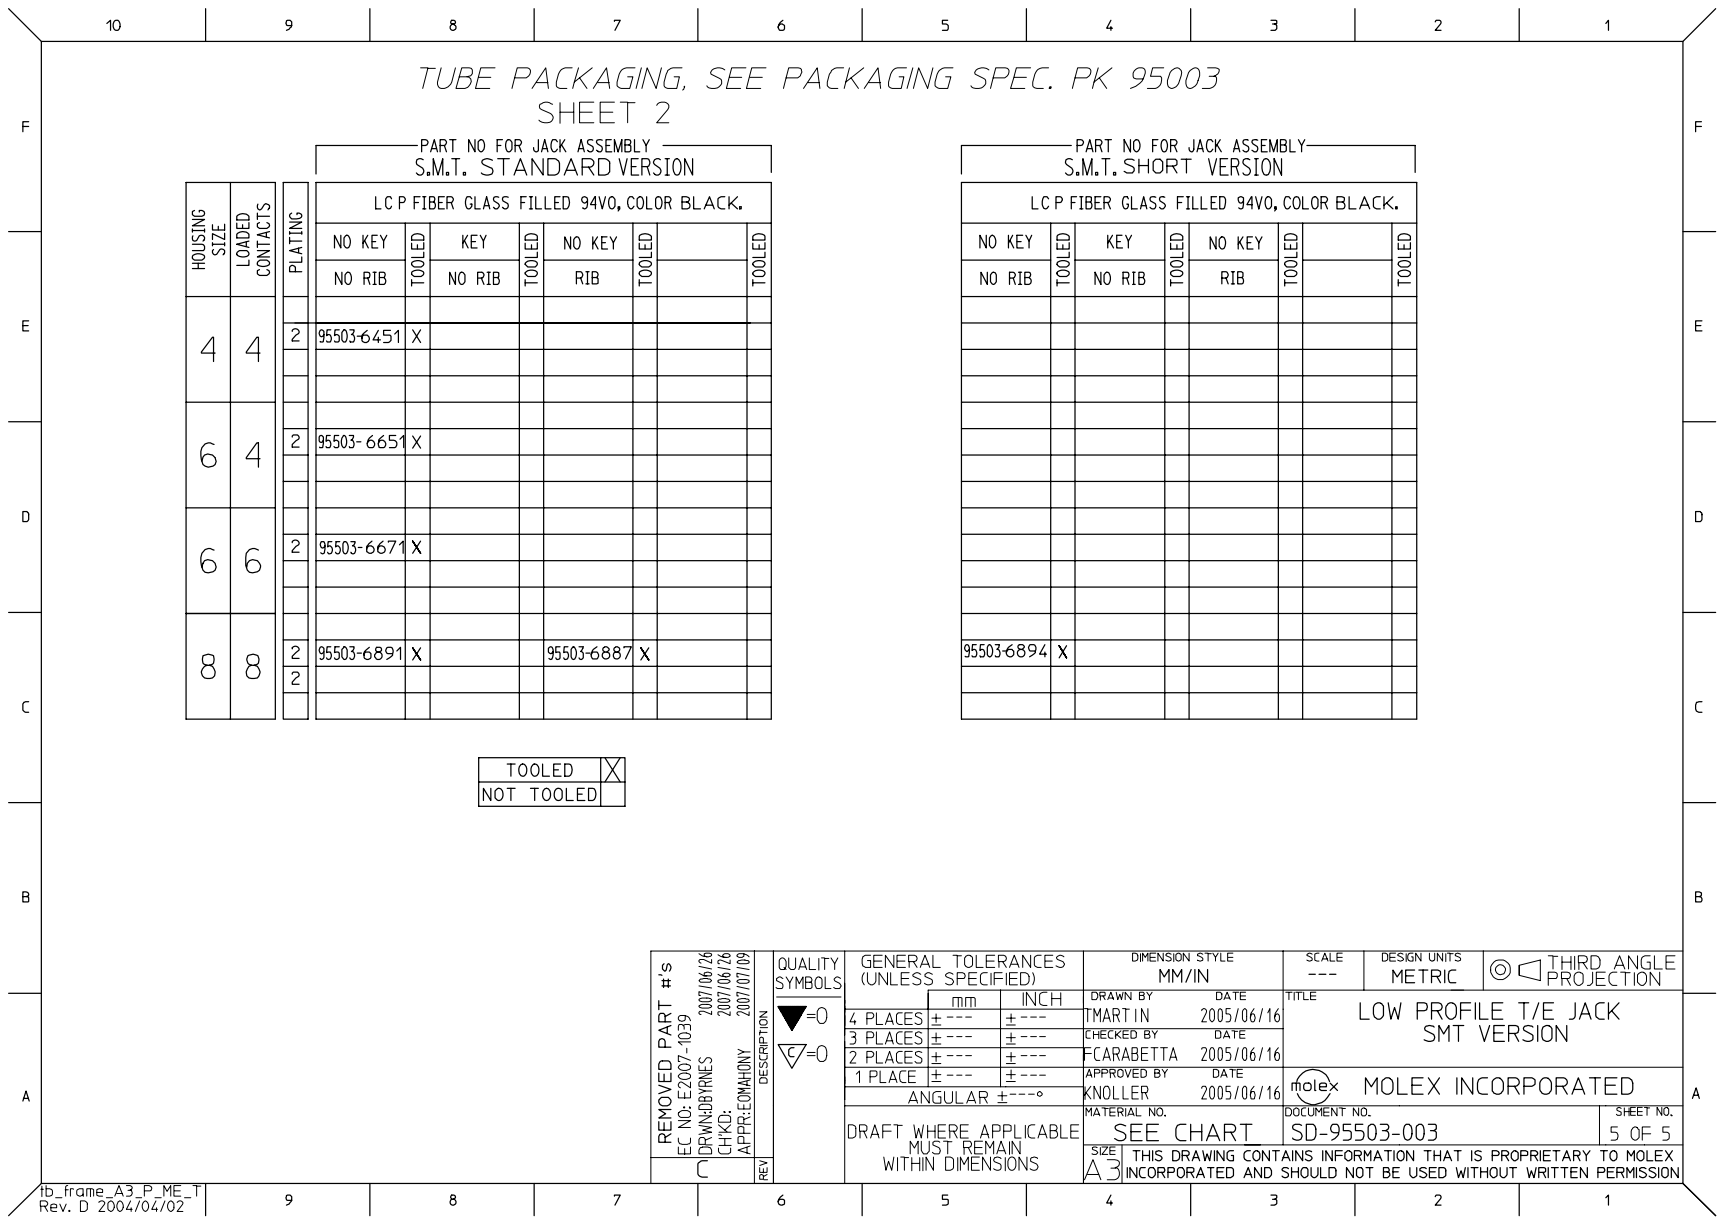
[picture p68: page 4]
