insinfo/8SoundsUSB/Hardware Design Files/8SoundsUSB_REV2.0.1/8SoundsUSB/PCB/8SoundsUSB_v1.1.pdf

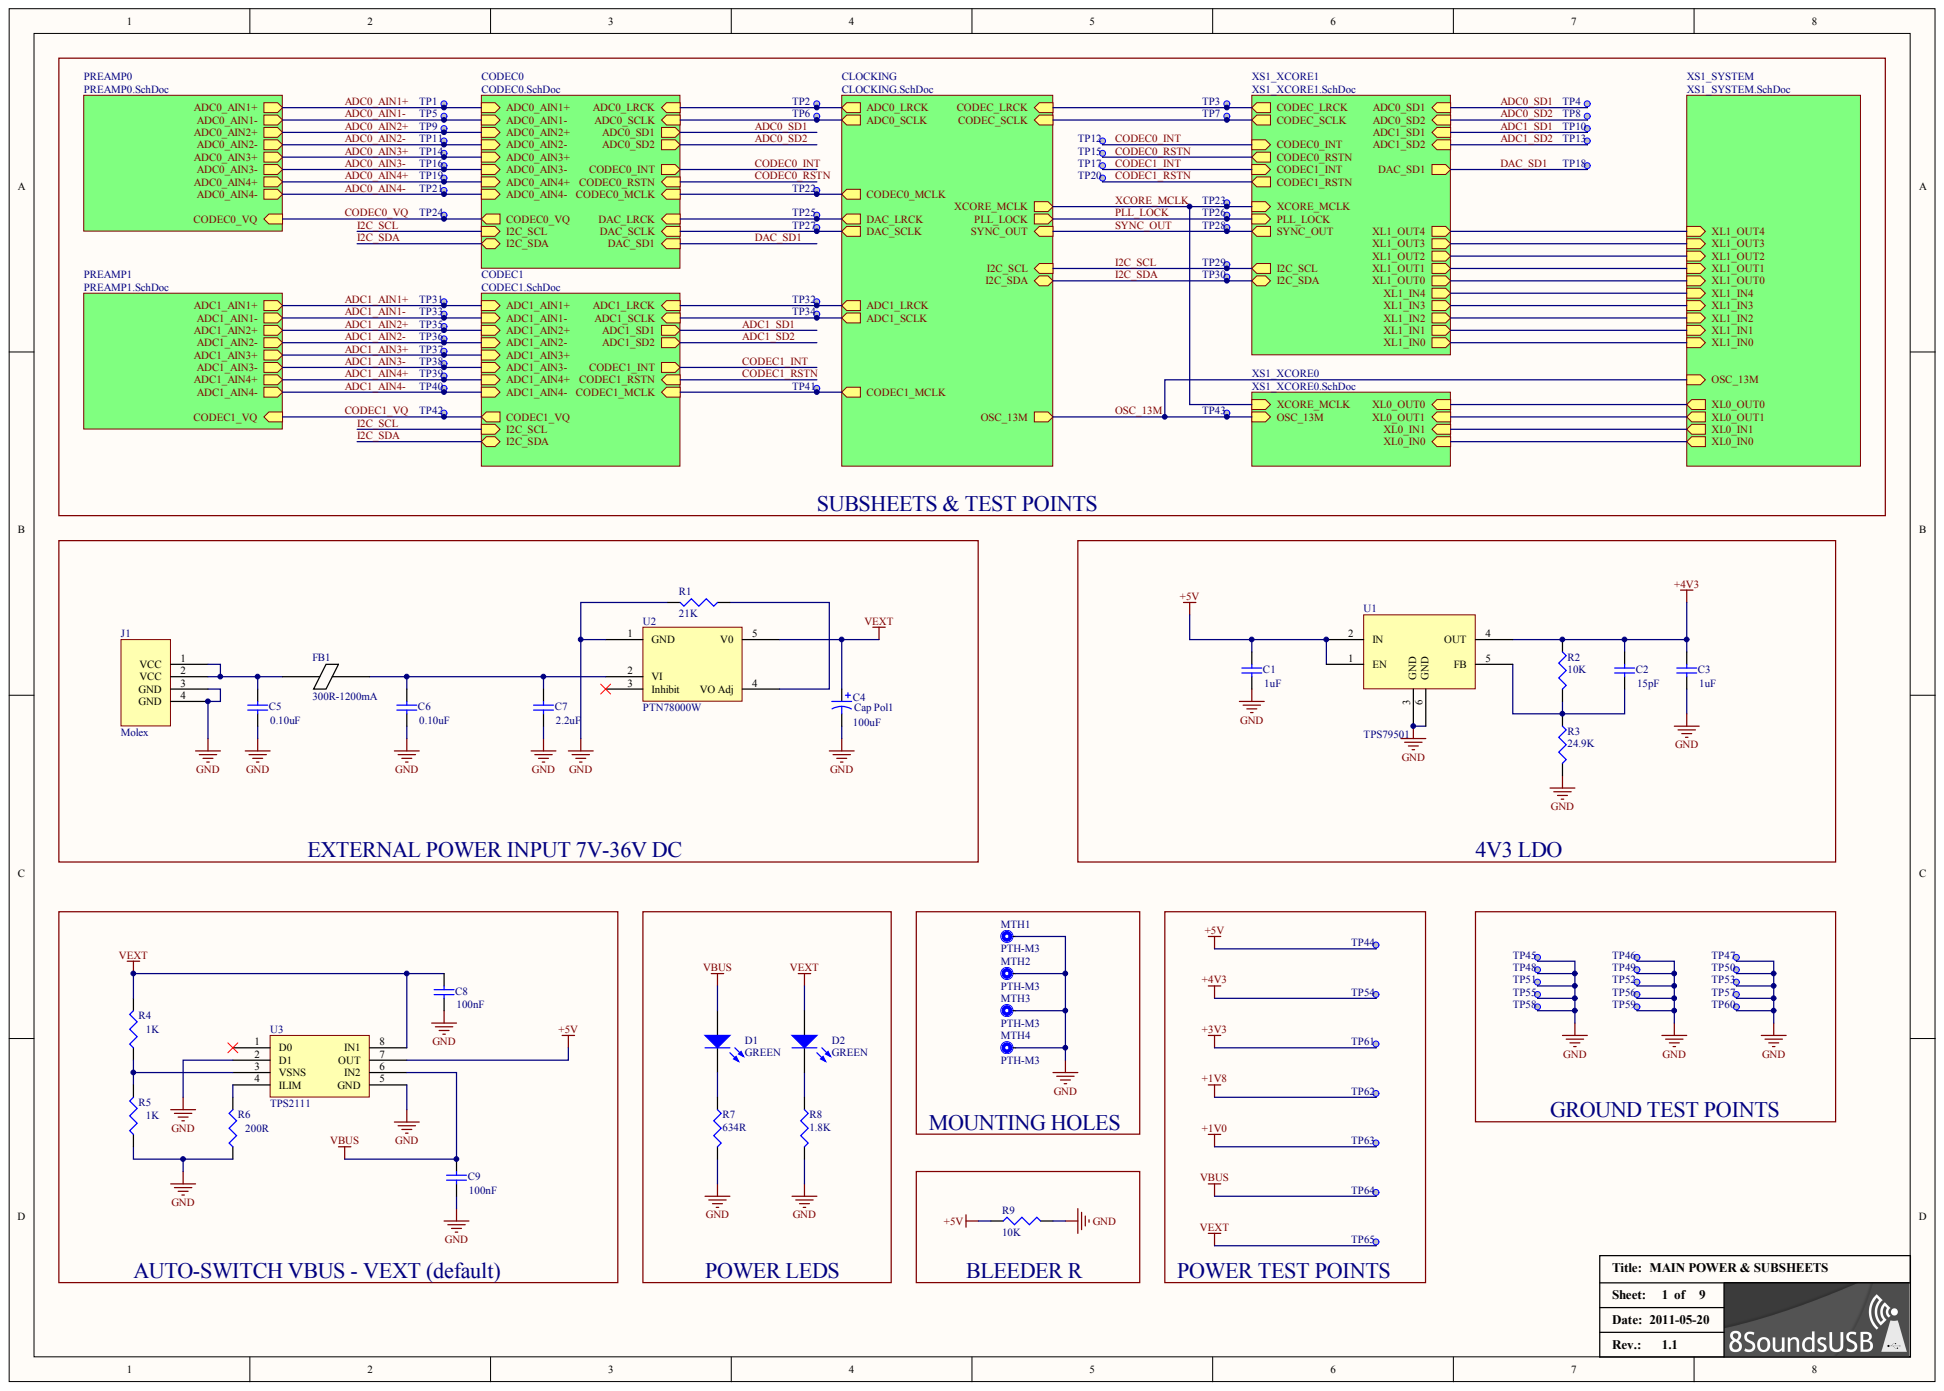
[picture p69: page 1]

ADC0_AIN1-TP5 | TP6 | TP7
ADC0_AIN2+ TP9 | ADC0_SD1 ADC0_SD2 CODEC0_INT CODEC0_RSTN TP22 | TP12 CODEC0_INT TP15 CODEC0_RSTN TP17 CODEC1_INT TP20 CODEC1_RSTN XCORE_MCLK TP23

CODEC0_VQ TP24 | TP25

TP27 | | SYNC_OUT | TP28

PLL_LOCK | TP26

ADC1_AIN1-TP33 | TP34
ADC1_AIN2+ TP35 | ADC1_SD1 ADC1_SD2 CODEC1_INT CODEC1_RSTN TP41

EXTERNAL POWER INPUT 7V-36V DC

AUTO-SWITCH VBUS - VEXT (default)

BLEEDER R

Sheet: 1 9 of

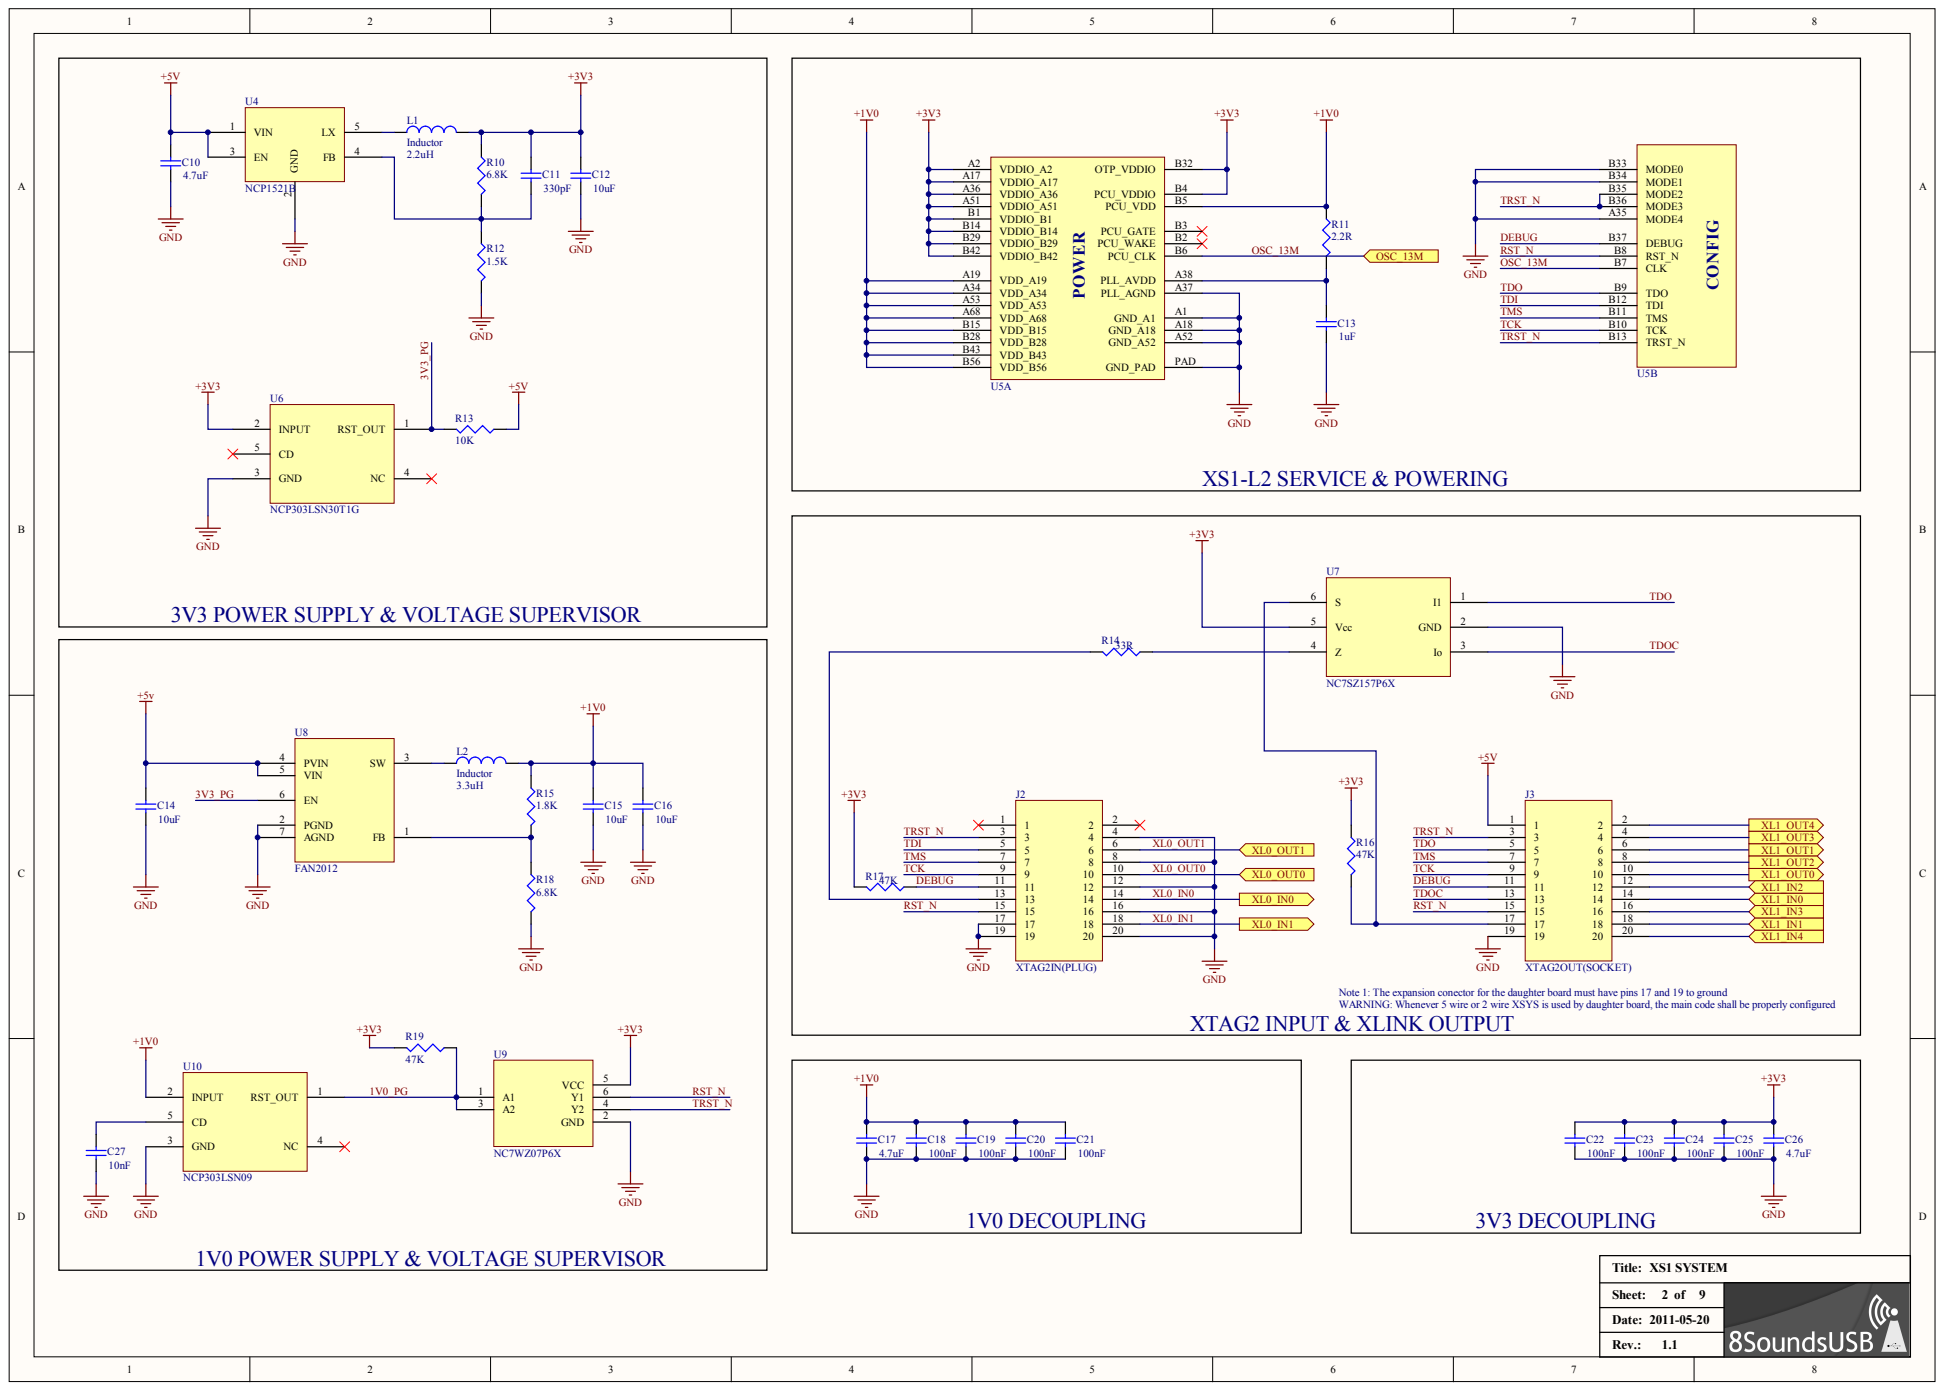
[picture p70: page 2]

3V3 POWER SUPPLY & VOLTAGE SUPERVISOR

Note 1: The expansion conector for the daughter board must have pins 17 and 19 to ground
WARNING: Whenever 5 wire or 2 wire XSYS is used by daughter board, the main code shall be properly configured

1V0 POWER SUPPLY & VOLTAGE SUPERVISOR

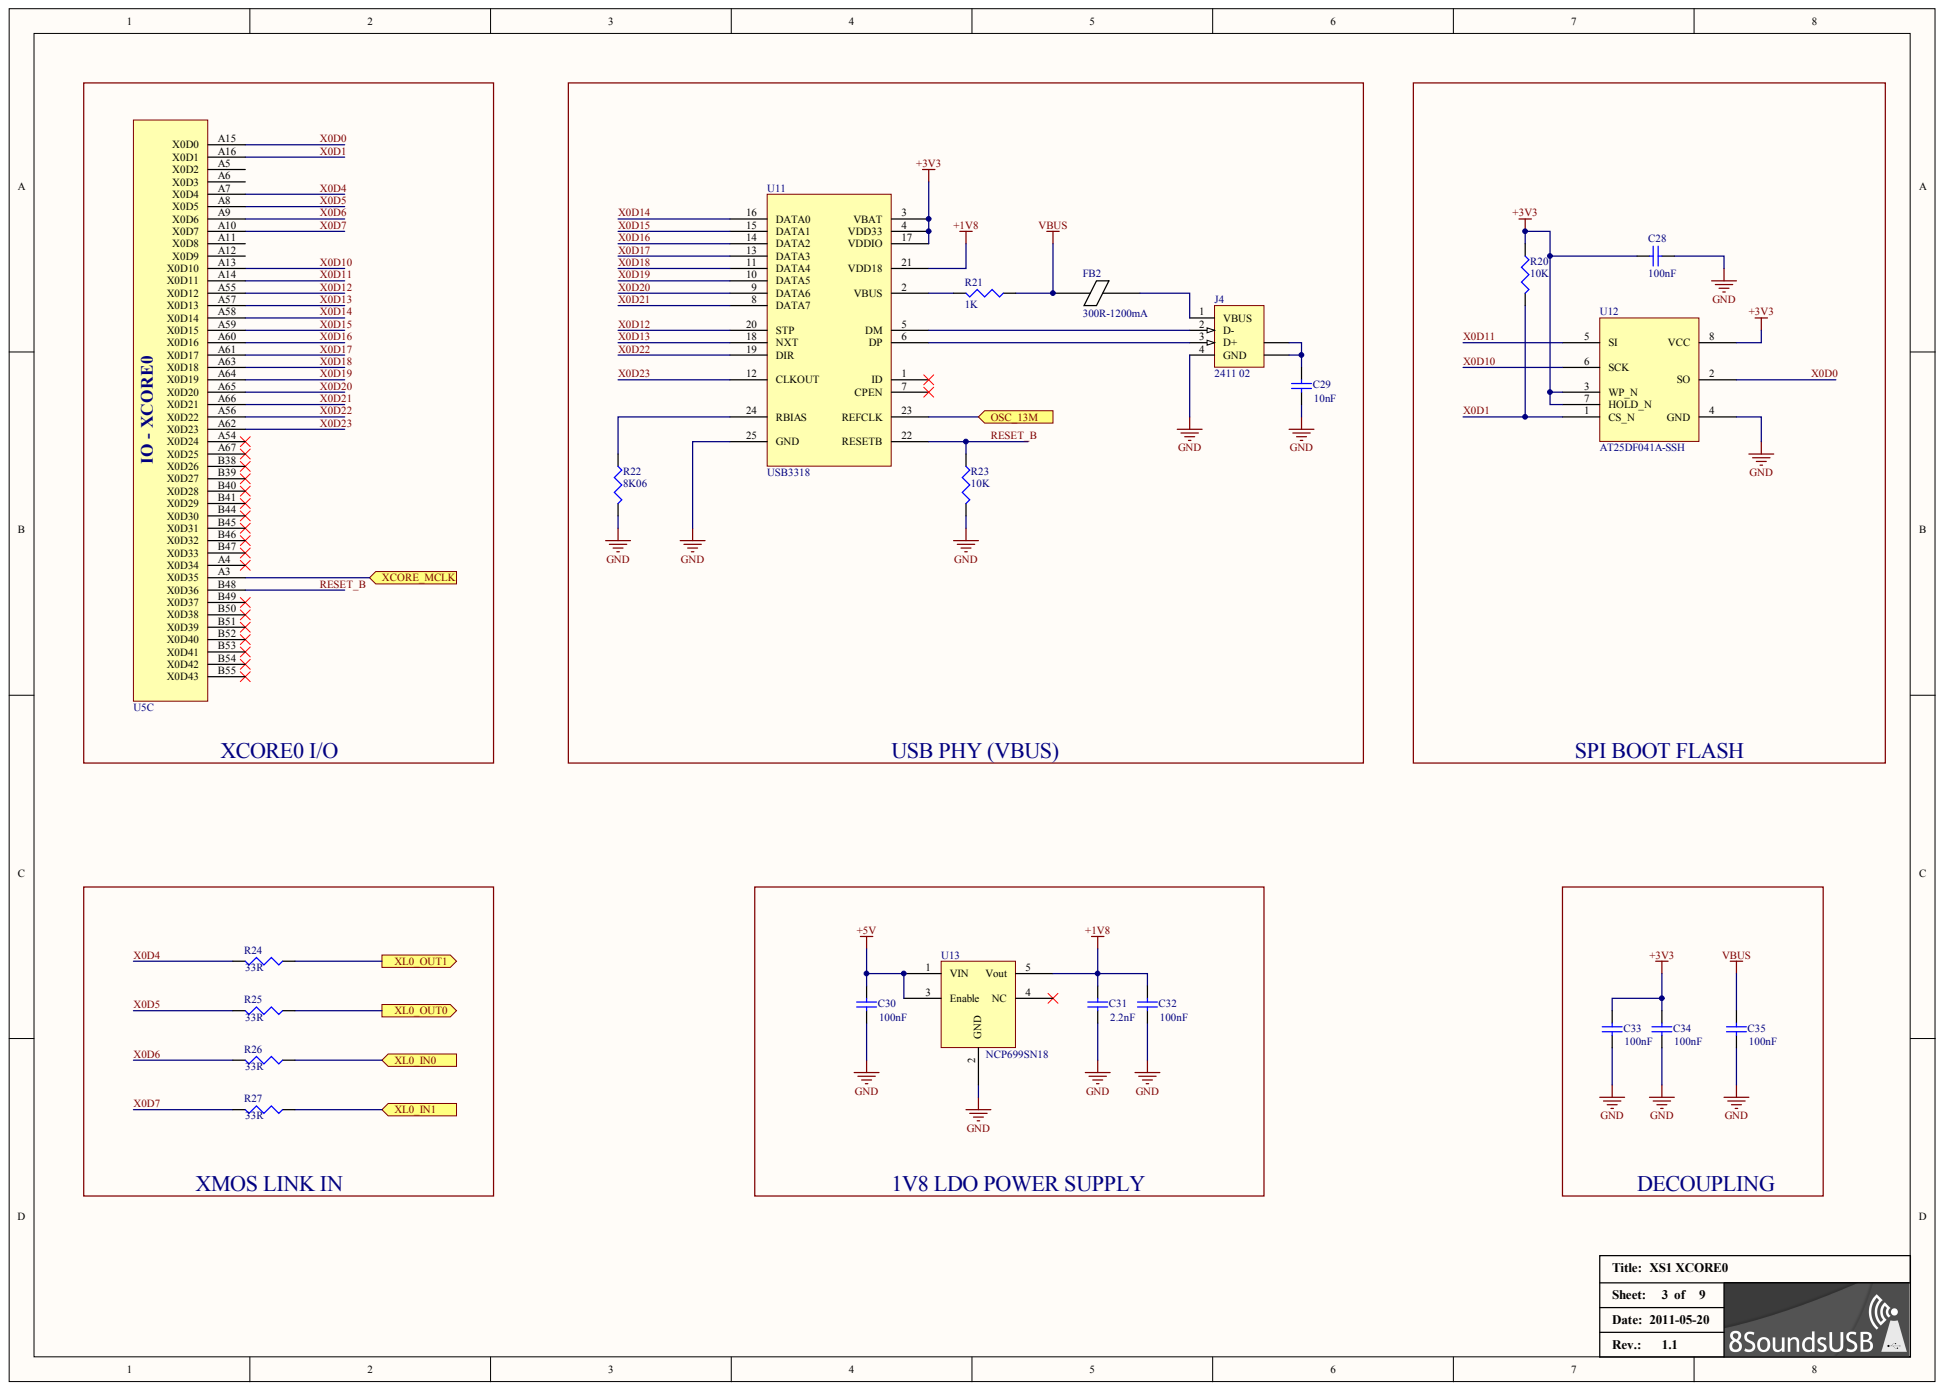
[picture p71: page 3]

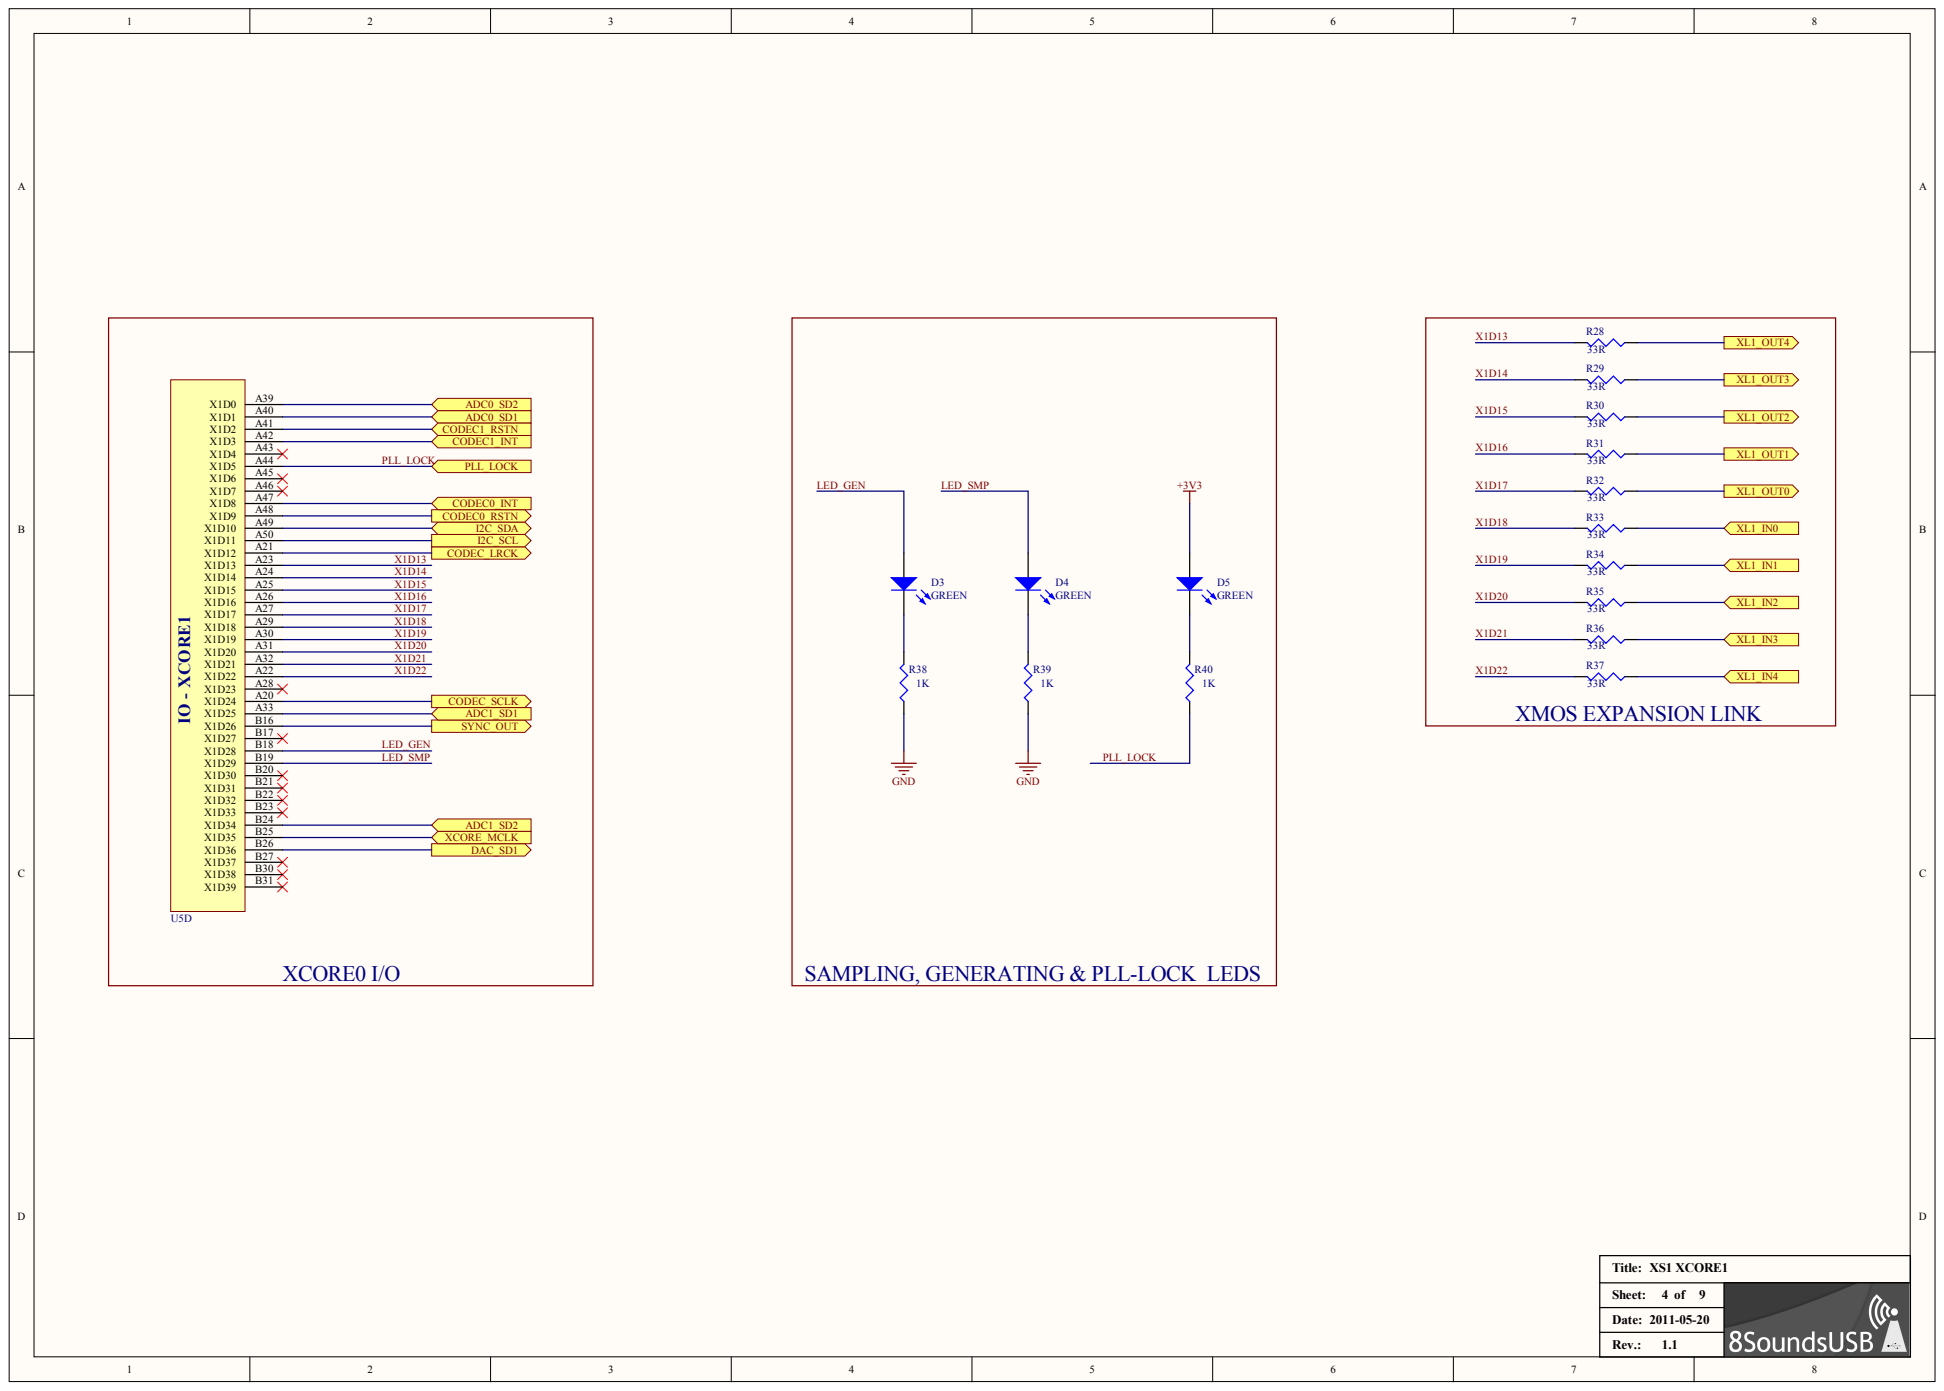
[picture p72: page 4]

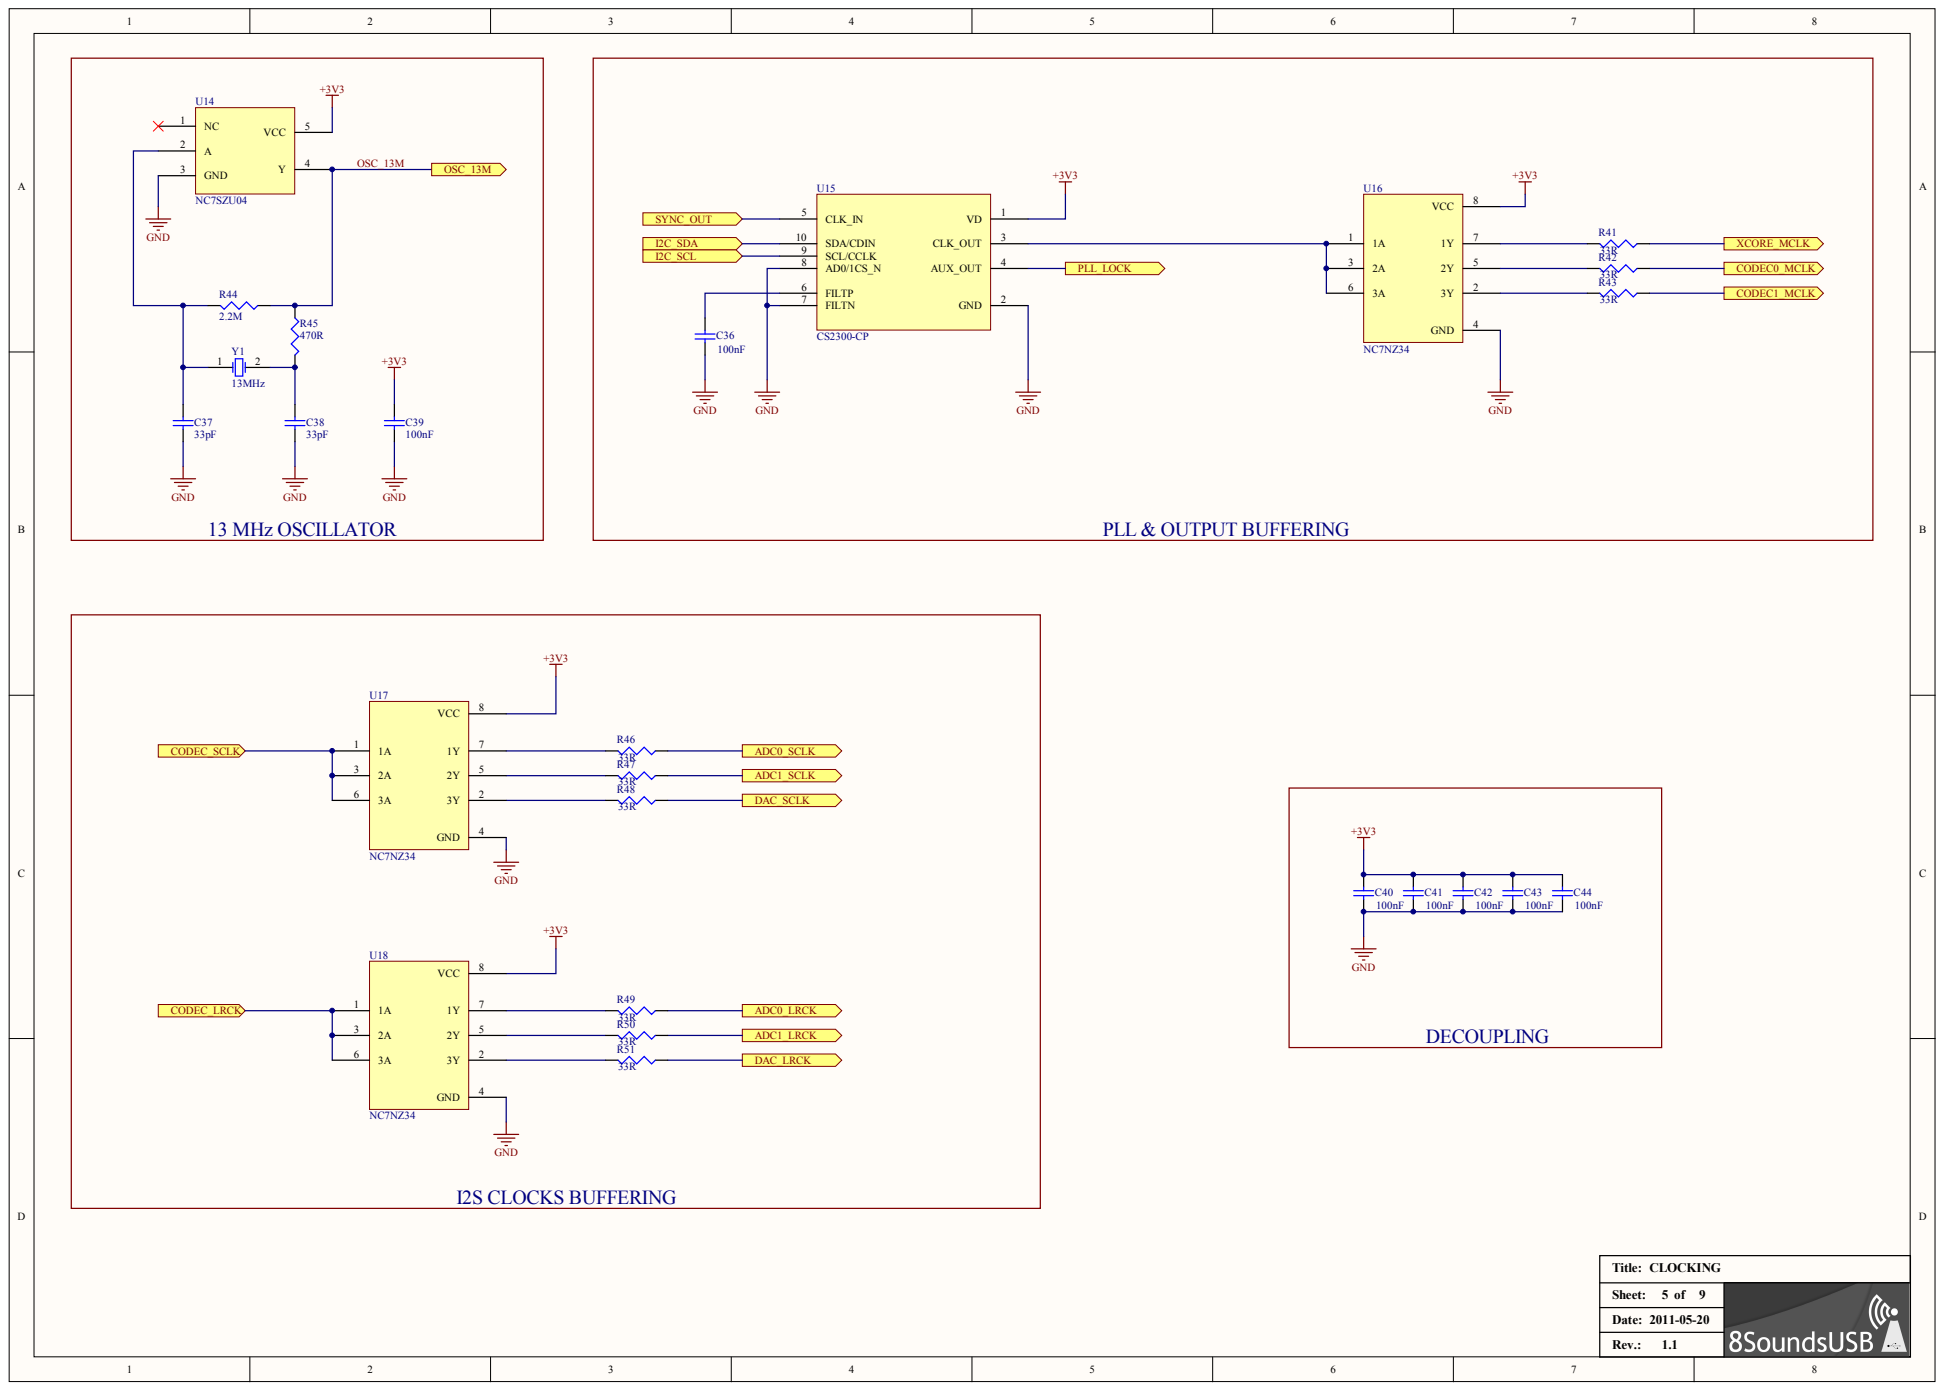
[picture p73: page 5]

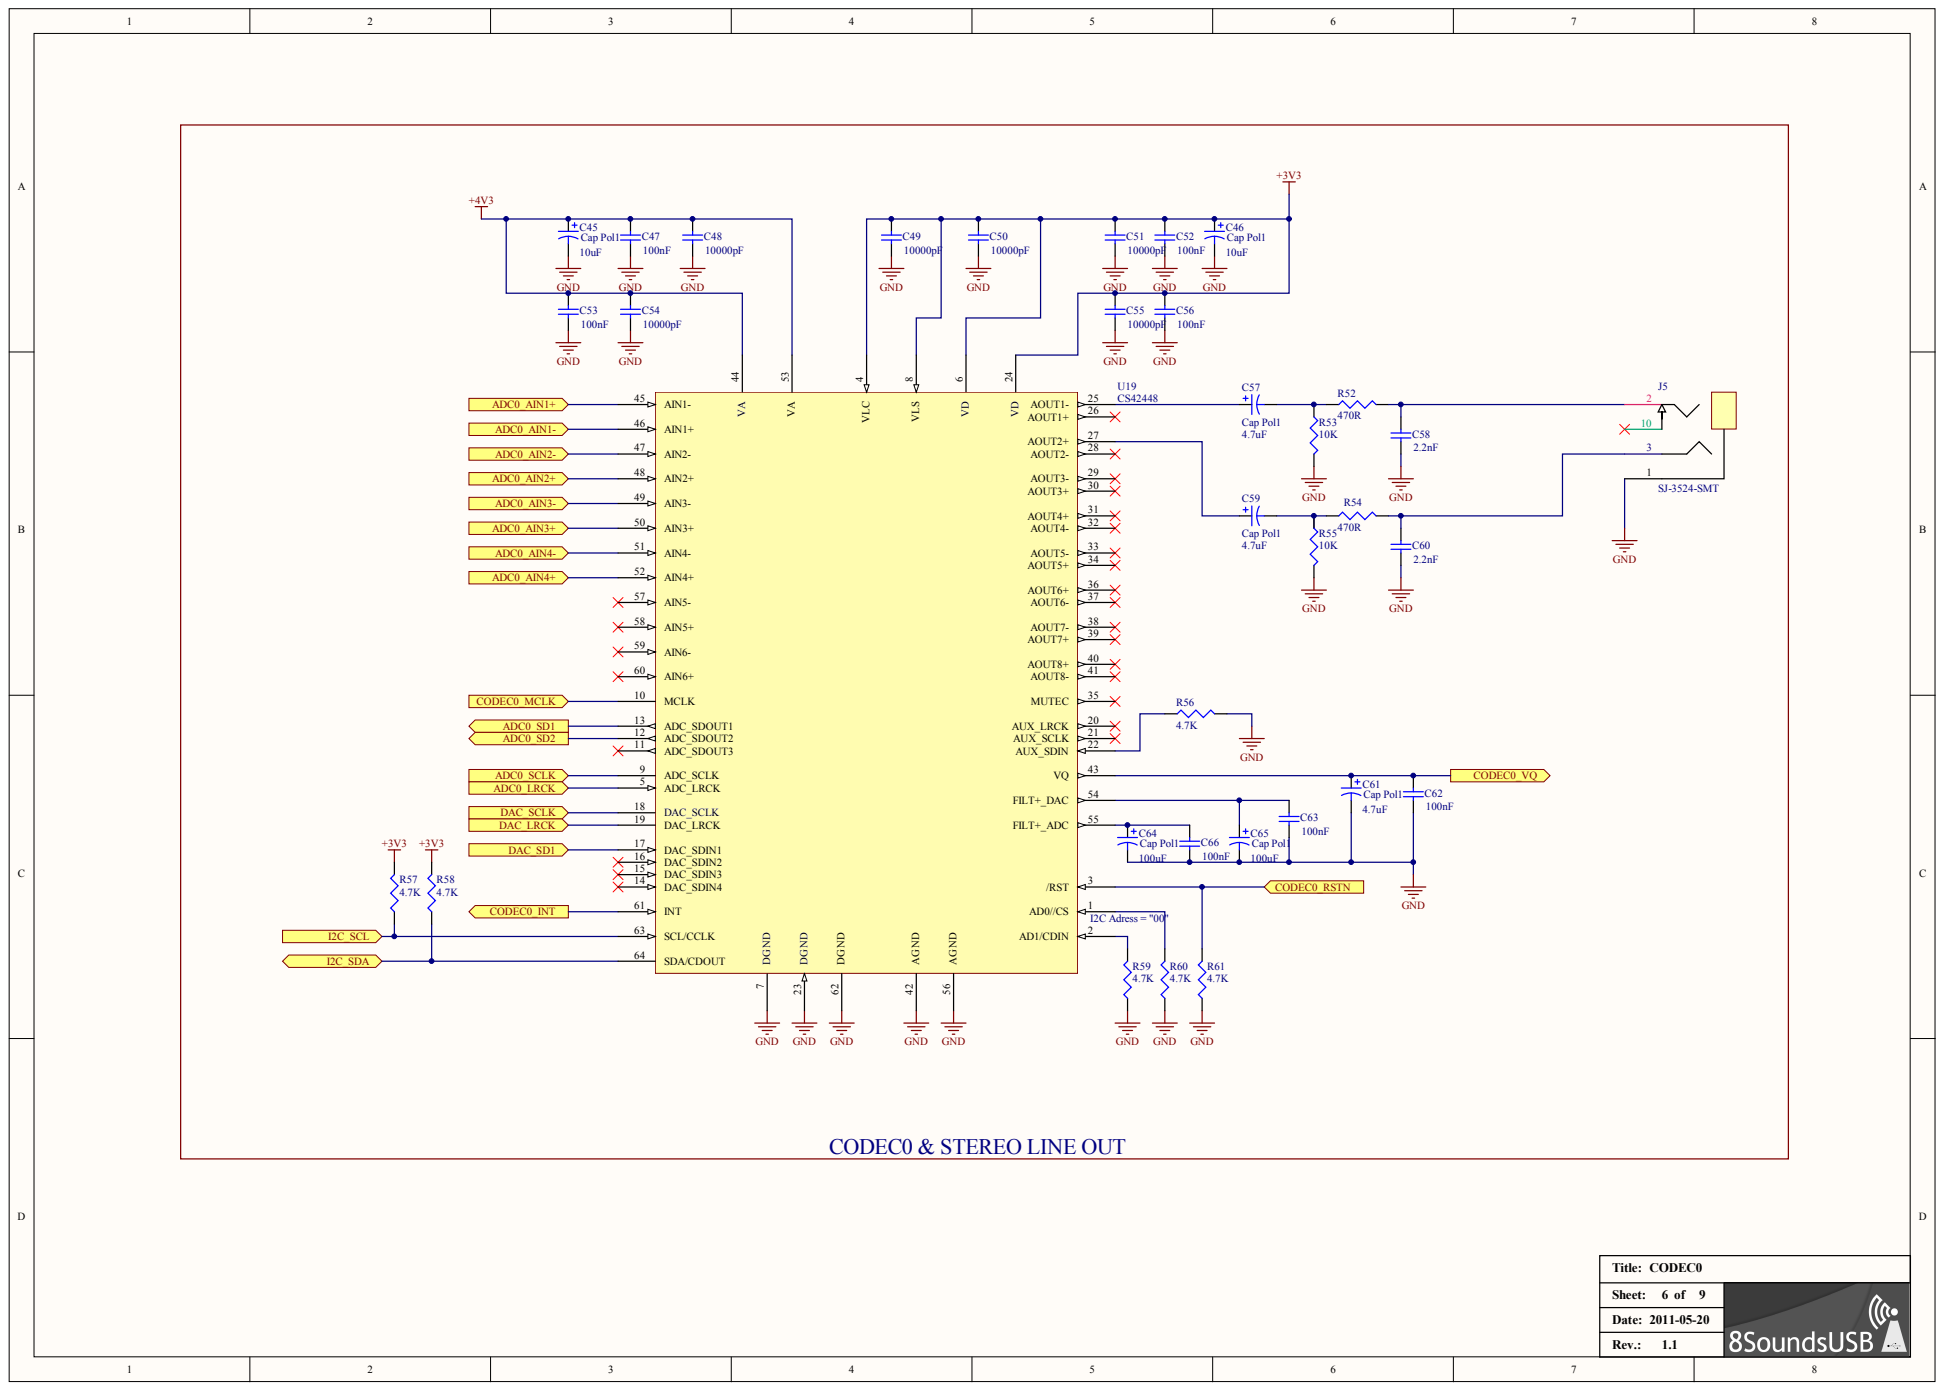
[picture p74: page 6]

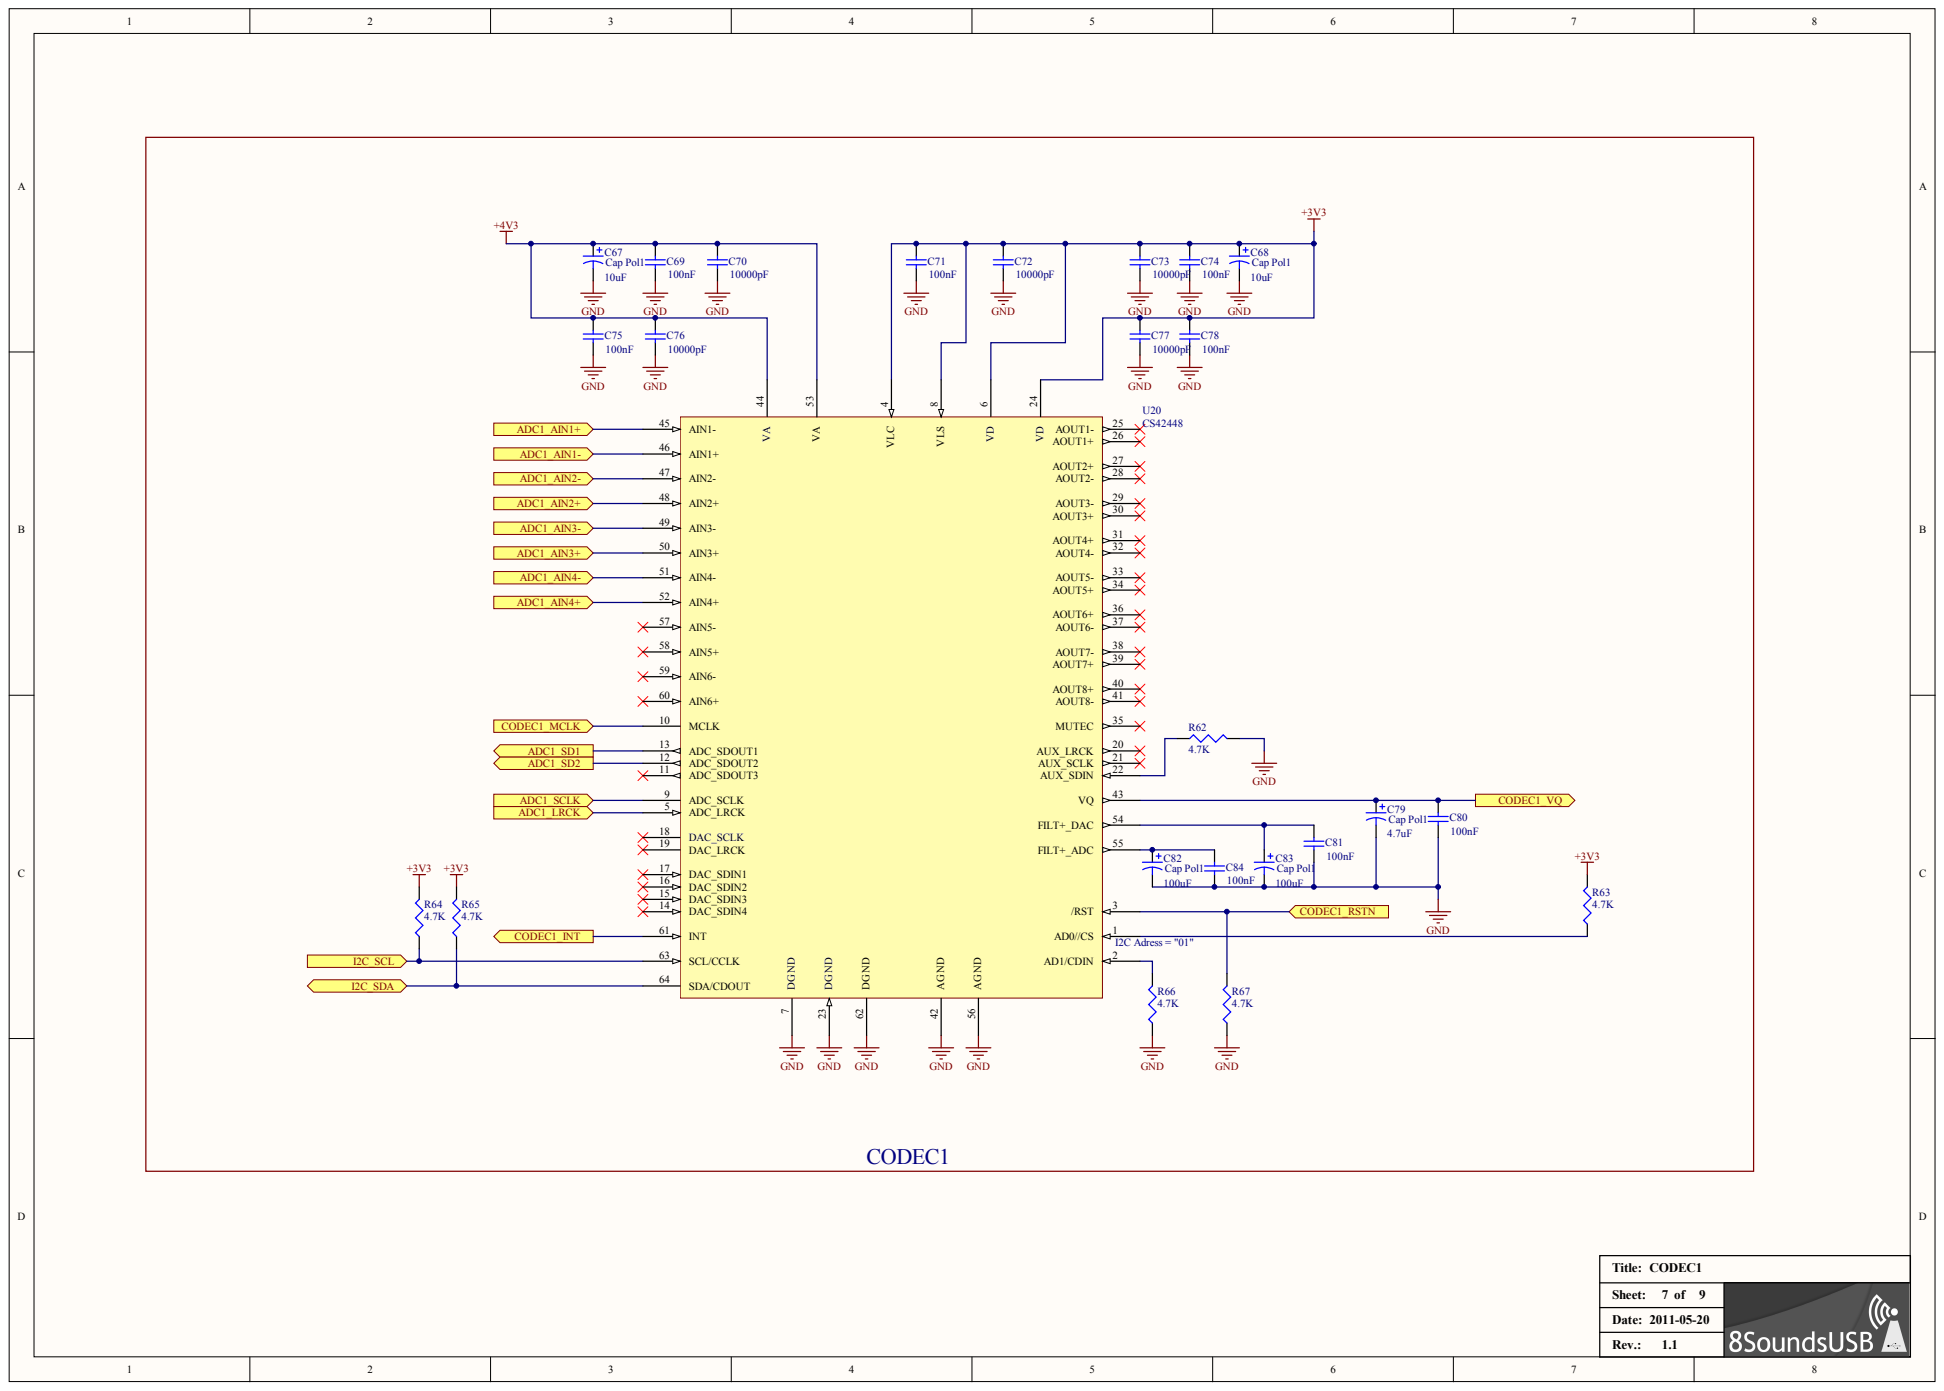
[picture p75: page 7]

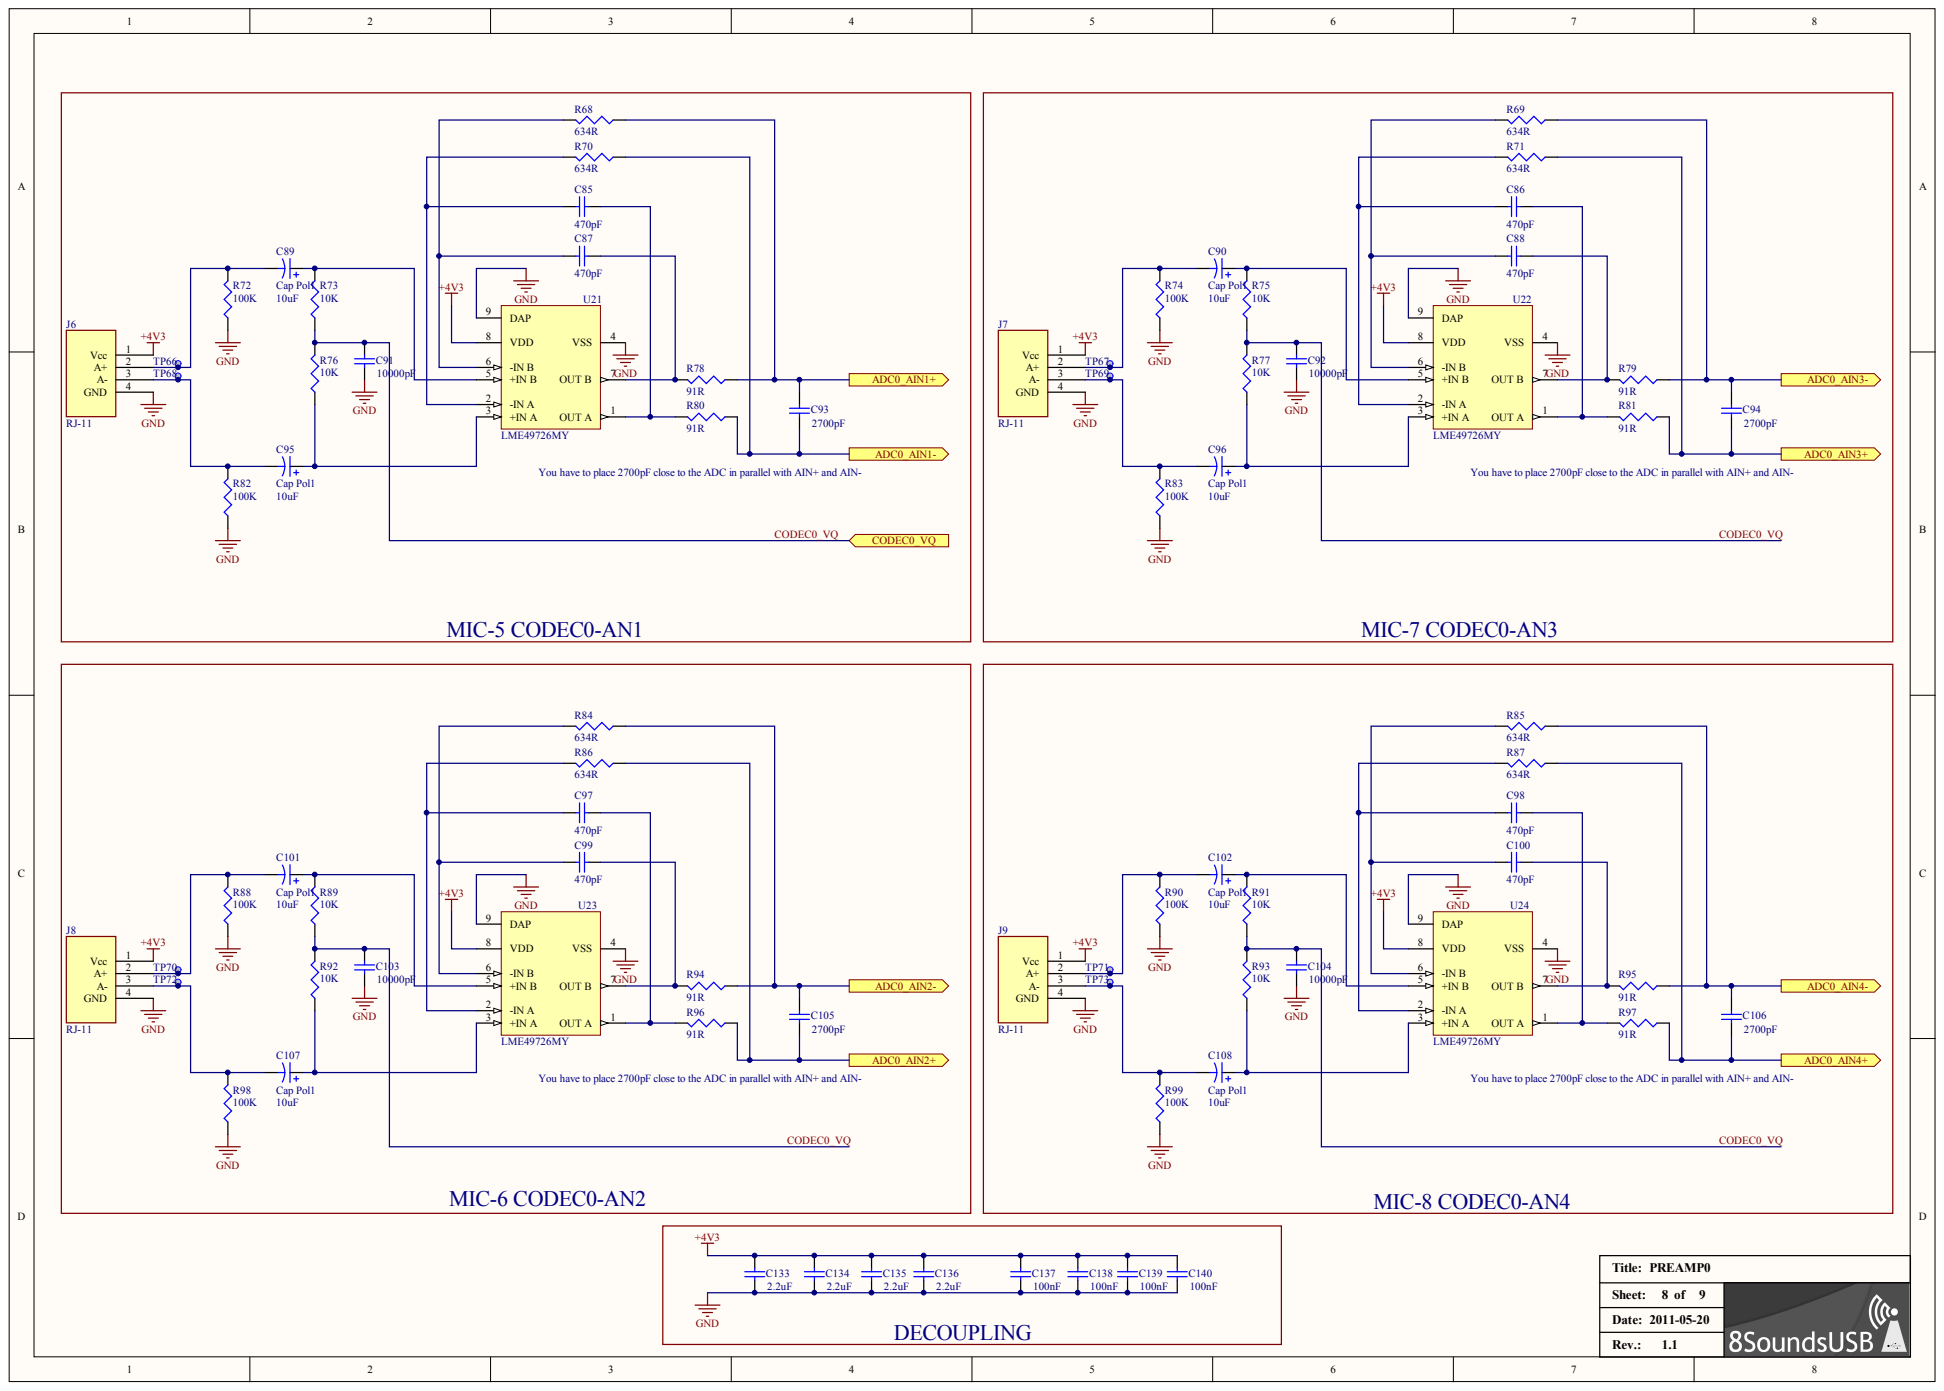
[picture p76: page 8]

You have to place 2700pF close to the ADC in parallel with AIN+ and AIN-

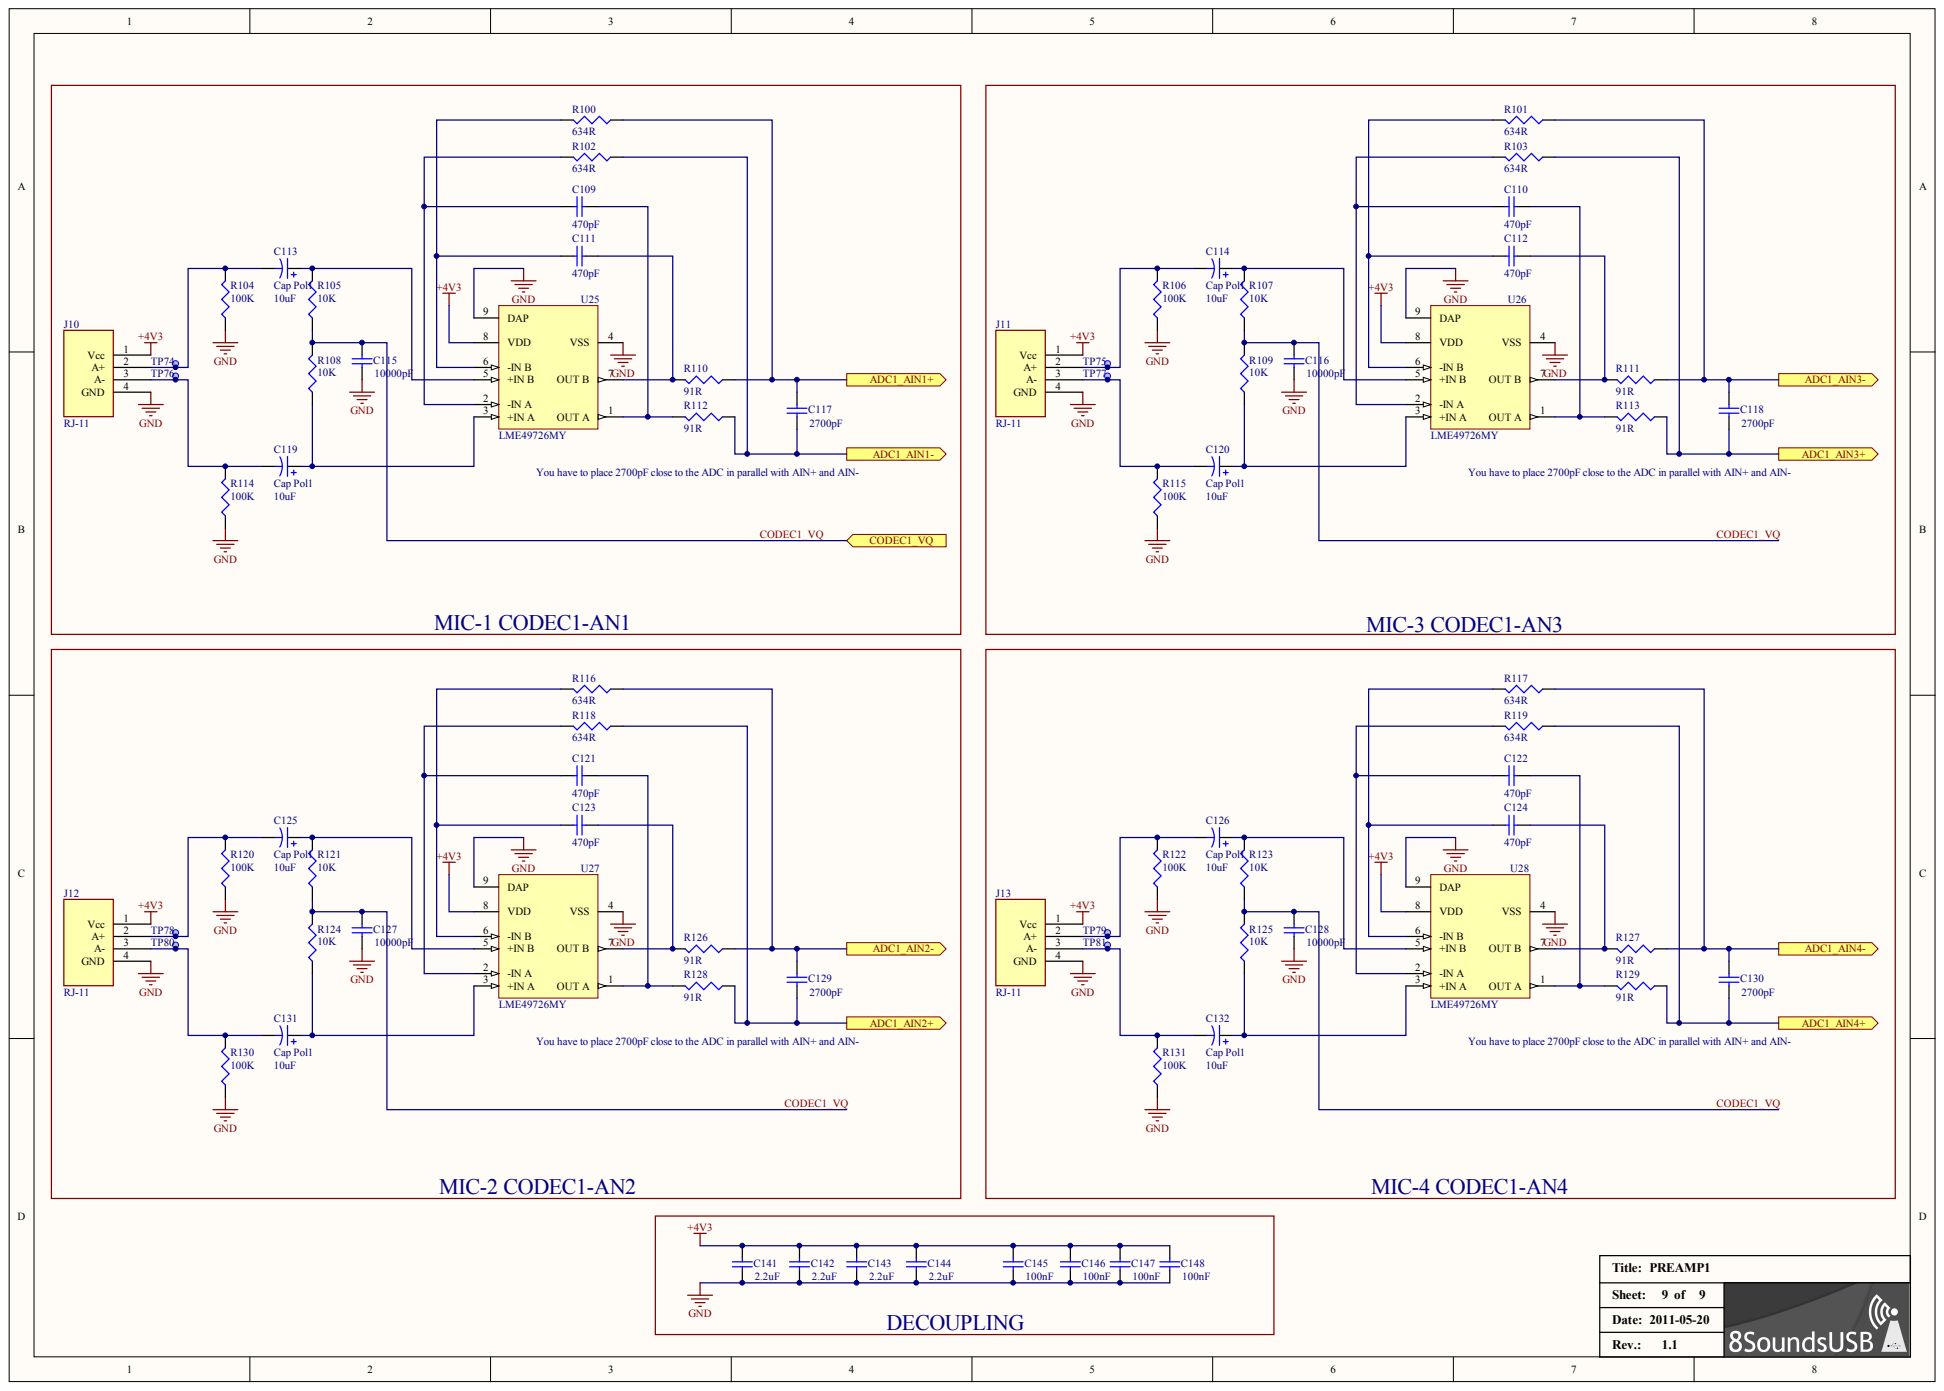
[picture p77: page 9]

You have to place 2700pF close to the ADC in parallel with AIN+ and AIN-
