insinfo/8SoundsUSB/(list of files, drawings)

Other design files:
Hardware Design Files/8SoundsUSB-Cable_REV2.0/8SoundsUSB-Cable/8SoundsUSB-Cable.SchDoc
Hardware Design Files/8SoundsUSB-MIC_REV2.0.1/8SoundsUSB-MIC/8SoundsUSB-MIC.PcbDoc
Hardware Design Files/8SoundsUSB-MIC_REV2.0.1/8SoundsUSB-MIC/8SoundsUSB-MIC.PrjPcb
Hardware Design Files/8SoundsUSB-MIC_REV2.0.1/8SoundsUSB-MIC/8SoundsUSB-MIC.SchDoc
Hardware Design Files/8SoundsUSB_REV2.0.1/8SoundsUSB/PCB/8SoundsUSB.PcbDoc
Hardware Design Files/8SoundsUSB_REV2.0.1/8SoundsUSB/PCB/8SoundsUSB.PrjPCB
Hardware Design Files/8SoundsUSB_REV2.0.1/8SoundsUSB/PCB/ANALOG_PWR.SchDoc
Hardware Design Files/8SoundsUSB_REV2.0.1/8SoundsUSB/PCB/CLOCKING.SchDoc
Hardware Design Files/8SoundsUSB_REV2.0.1/8SoundsUSB/PCB/CODEC0.SchDoc
Hardware Design Files/8SoundsUSB_REV2.0.1/8SoundsUSB/PCB/CODEC1.SchDoc
Hardware Design Files/8SoundsUSB_REV2.0.1/8SoundsUSB/PCB/MAIN_POWER.SchDoc
Hardware Design Files/8SoundsUSB_REV2.0.1/8SoundsUSB/PCB/POWER.SchDoc
Hardware Design Files/8SoundsUSB_REV2.0.1/8SoundsUSB/PCB/PREAMP0.SchDoc
Hardware Design Files/8SoundsUSB_REV2.0.1/8SoundsUSB/PCB/PREAMP1.SchDoc
Hardware Design Files/8SoundsUSB_REV2.0.1/8SoundsUSB/PCB/XS1_SYSTEM.SchDoc
Hardware Design Files/8SoundsUSB_REV2.0.1/8SoundsUSB/PCB/XS1_XCORE0.SchDoc
Hardware Design Files/8SoundsUSB_REV2.0.1/8SoundsUSB/PCB/XS1_XCORE1.SchDoc
